adwikara/Ecobin/hardware/motors/lid_motor/connections.jpg

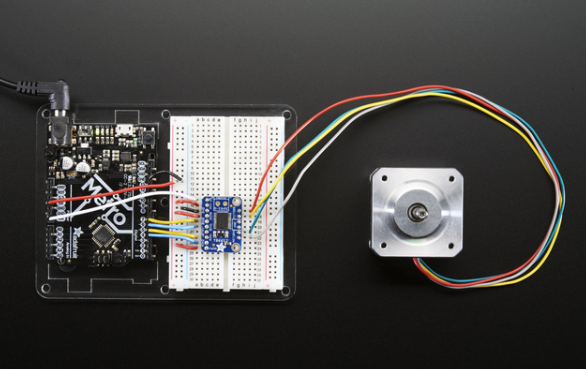
hardware/motors/lid_motor/connections.jpg
