adwikara/Ecobin/software/recognition/figures/best_case_0227/44.png

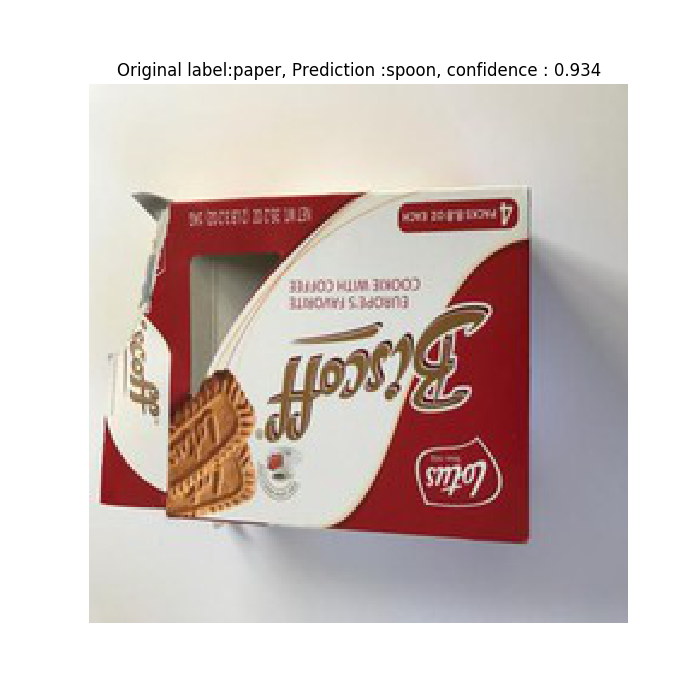
software/recognition/figures/best_case_0227/44.png
