adwikara/Ecobin/hardware/individual_sensors/README.md

This is a directory for all sensor modules used in Ecobin. Each file corresponds to the type of eponymous sensor
