adwikara/Ecobin/hardware/pi/README.md

# Pi Control
The ecobin.py script integrates the RasPi, sensors, and the backend. It is used for prototyping purposes.
