adwikara/Ecobin/hardware/motors/lid_motor/README.md

## Setup
1. Connect the Arduino, motor, and driver as shown in connections.jpg
2. Compile and load the code into the Arduino Uno
2. Power the Arduino via the Pi
