adwikara/Ecobin/Architechture.png

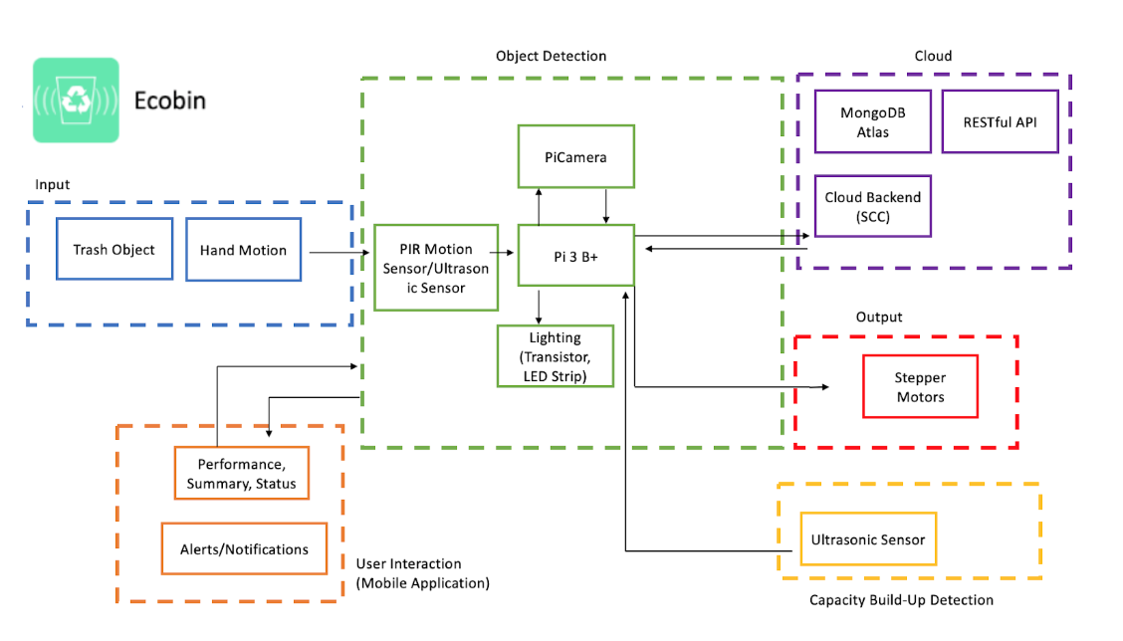
Architechture.png
