adwikara/Ecobin/hardware/pi/block_diagram.jpg

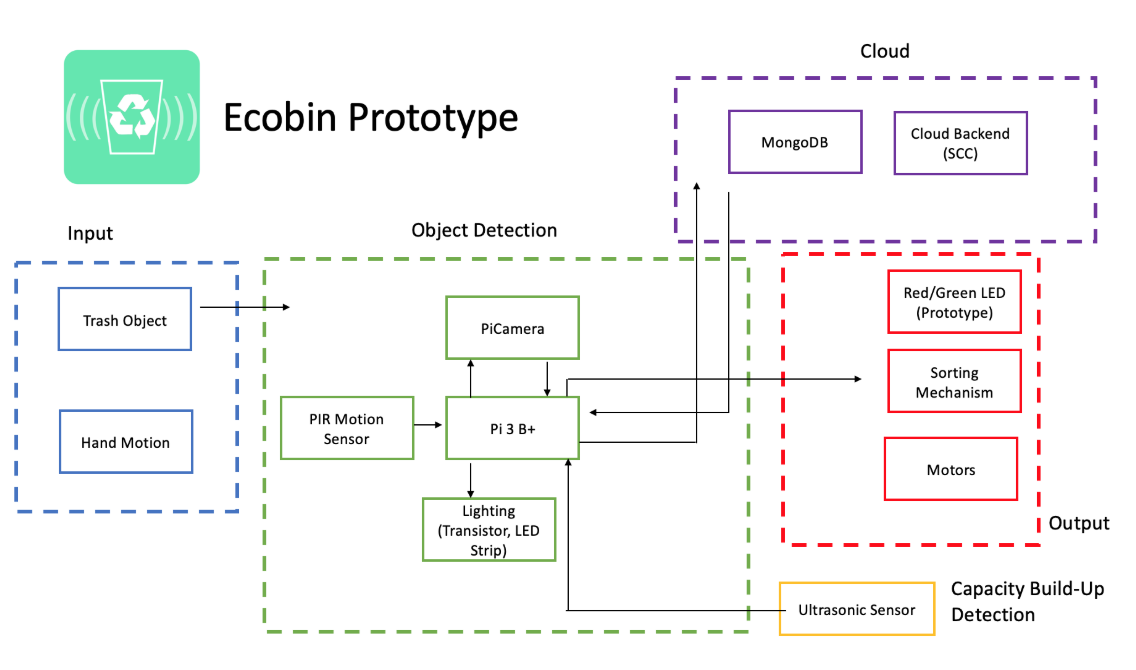
hardware/pi/block_diagram.jpg
