adwikara/Ecobin/hardware/pi/hw_connections.jpg

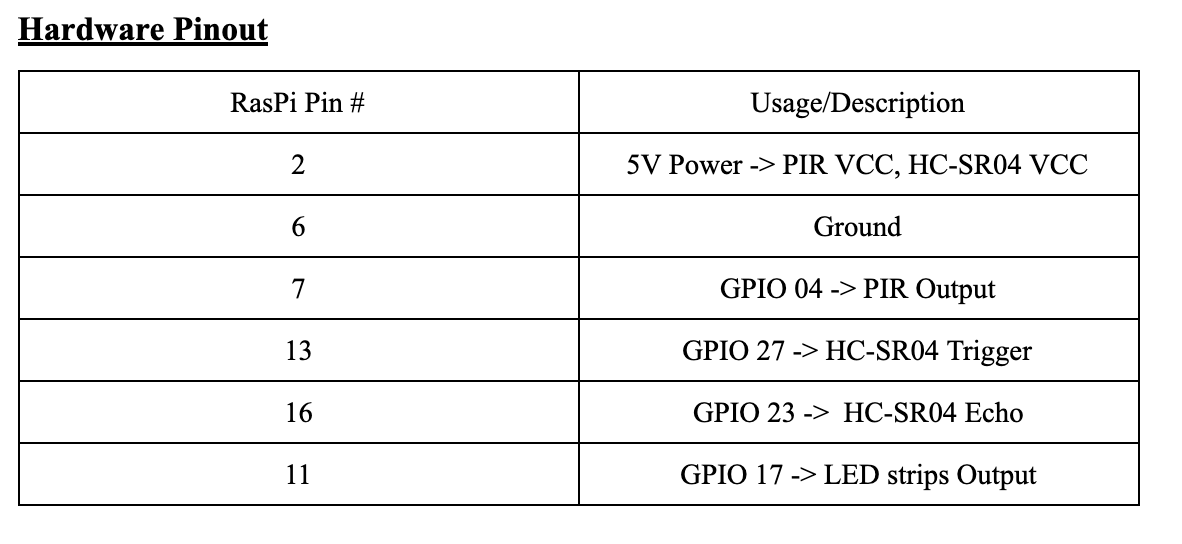
hardware/pi/hw_connections.jpg
