adwikara/Ecobin/hardware/Schematic.png

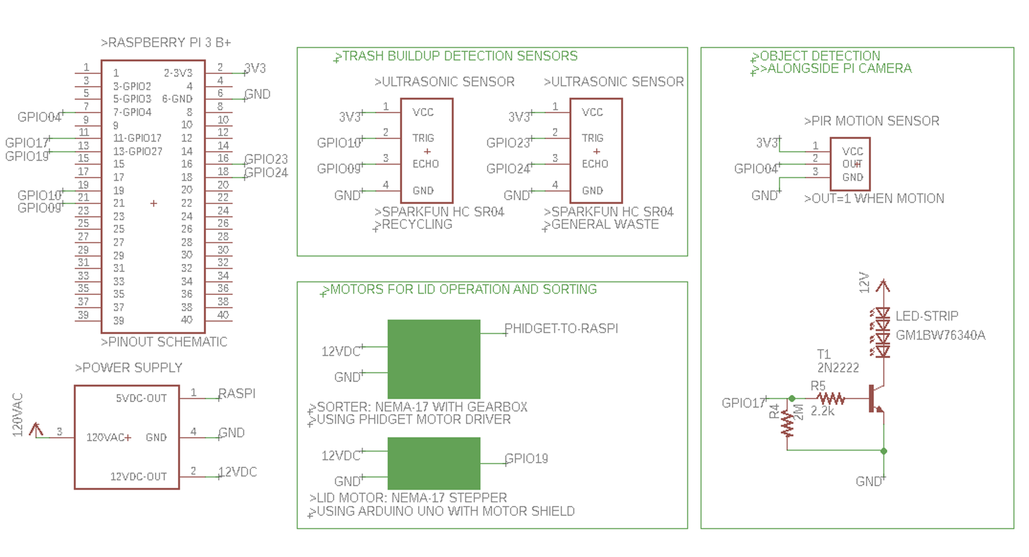
hardware/Schematic.png
