adwikara/Ecobin/software/recognition/figures/best_case_0227/0.png

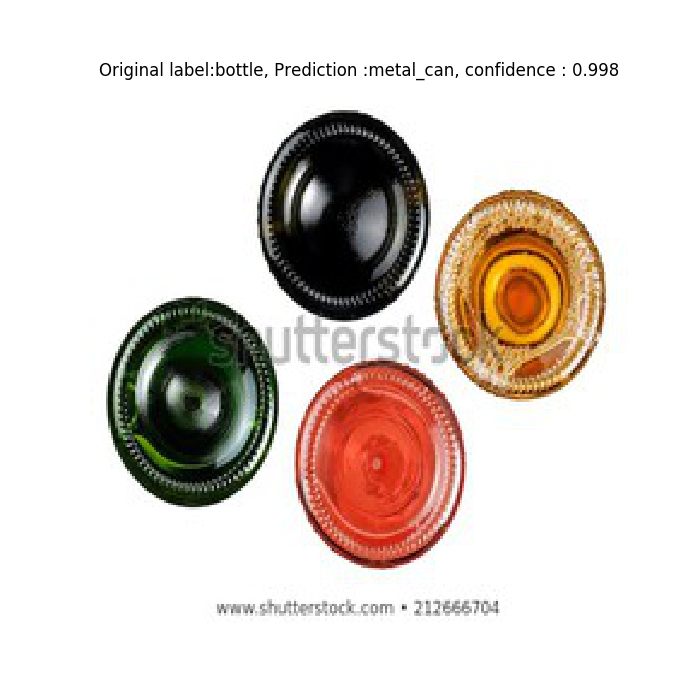
software/recognition/figures/best_case_0227/0.png
