adwikara/Ecobin/software/recognition/figures/best_case_0227/1.png

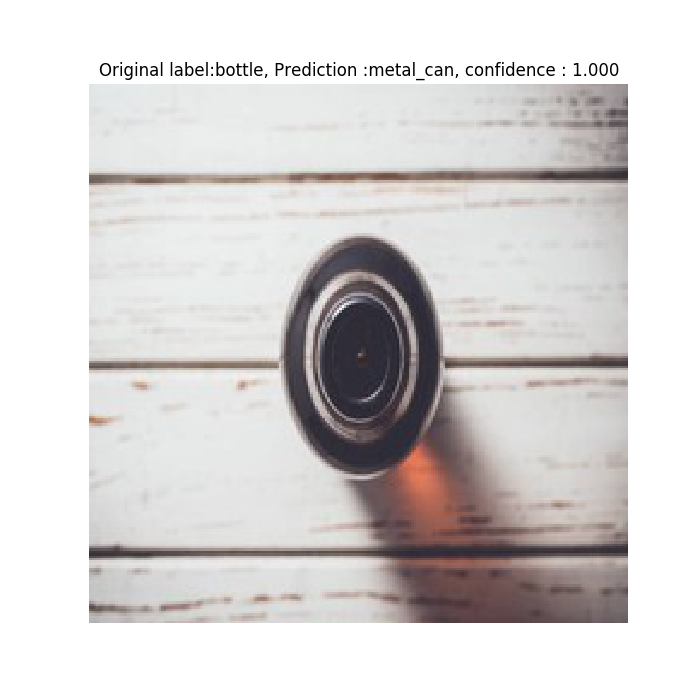
software/recognition/figures/best_case_0227/1.png
