adwikara/Ecobin/software/recognition/figures/best_case_0227/2.png

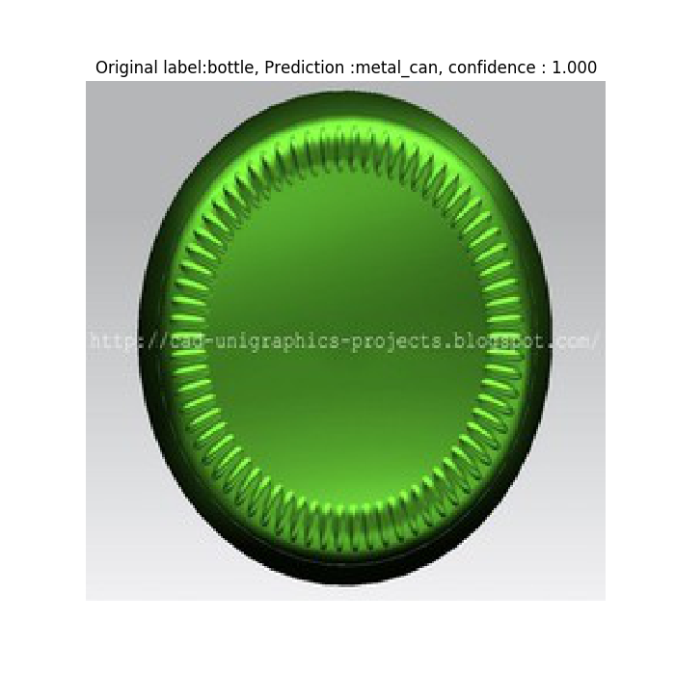
software/recognition/figures/best_case_0227/2.png
