adwikara/Ecobin/software/recognition/figures/best_case_0227/3.png

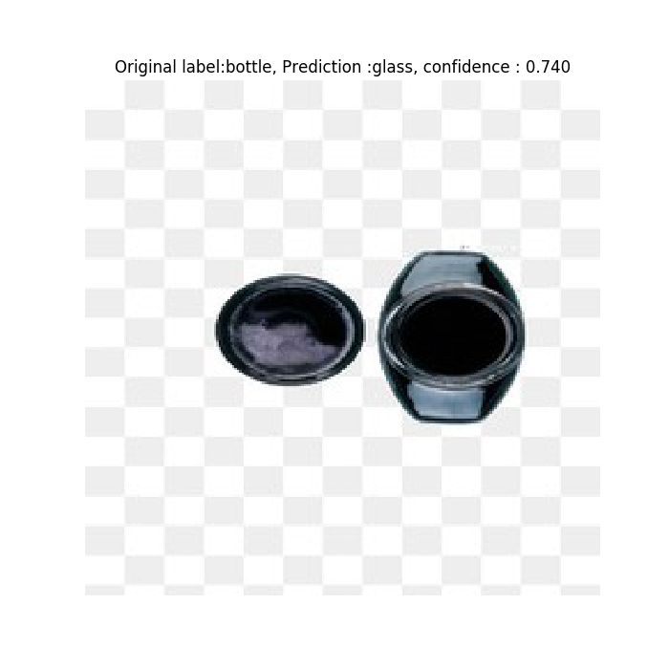
software/recognition/figures/best_case_0227/3.png
