adwikara/Ecobin/software/recognition/figures/best_case_0227/4.png

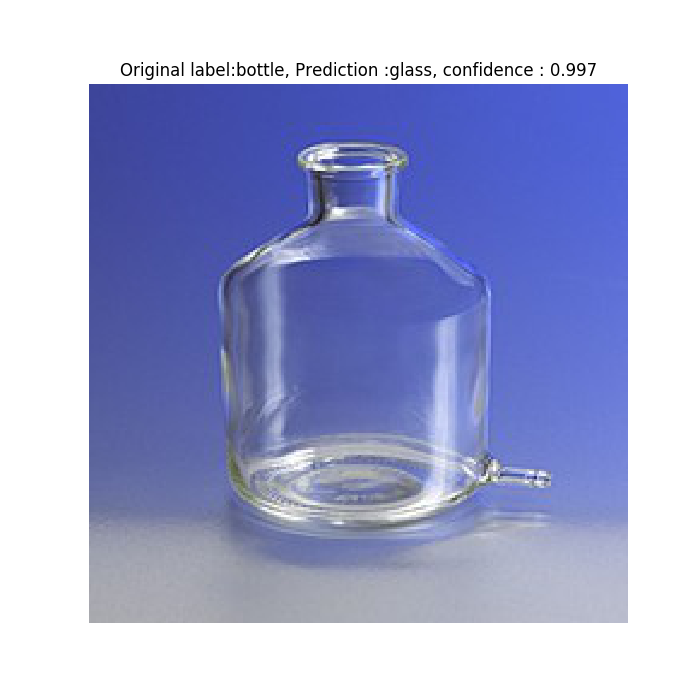
software/recognition/figures/best_case_0227/4.png
