adwikara/Ecobin/software/recognition/figures/best_case_0227/5.png

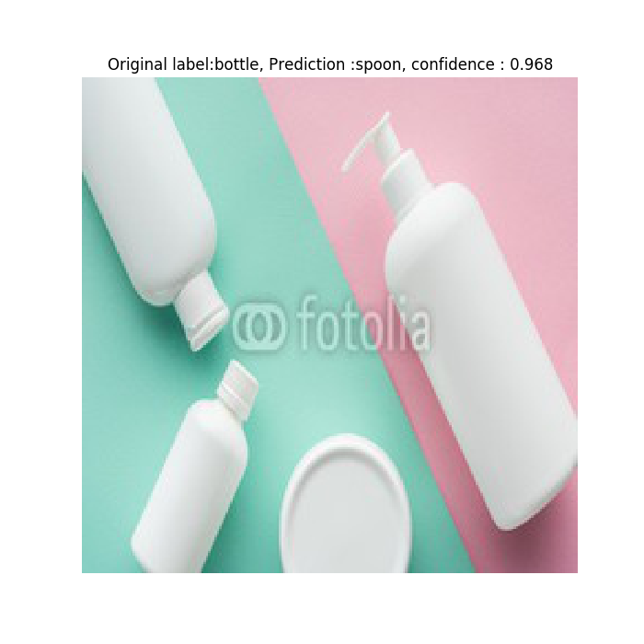
software/recognition/figures/best_case_0227/5.png
