adwikara/Ecobin/software/recognition/figures/best_case_0227/6.png

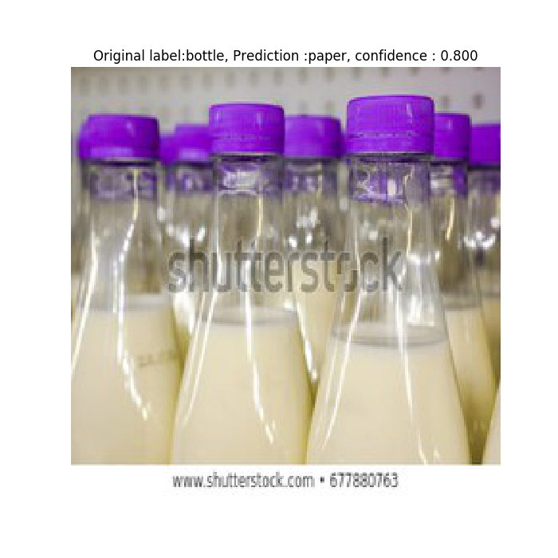
software/recognition/figures/best_case_0227/6.png
