adwikara/Ecobin/software/recognition/figures/best_case_0227/7.png

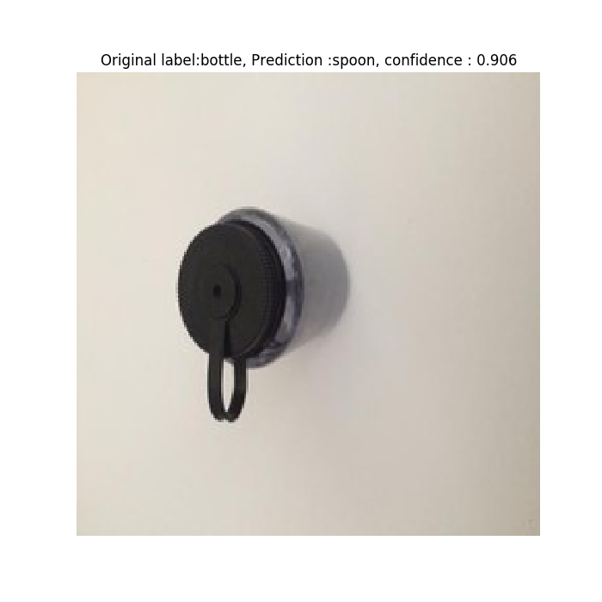
software/recognition/figures/best_case_0227/7.png
