adwikara/Ecobin/software/recognition/figures/best_case_0227/8.png

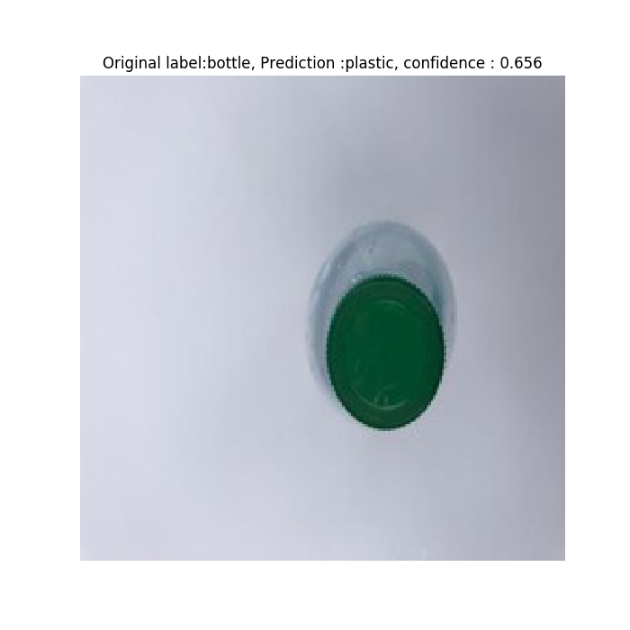
software/recognition/figures/best_case_0227/8.png
