adwikara/Ecobin/software/recognition/figures/best_case_0227/9.png

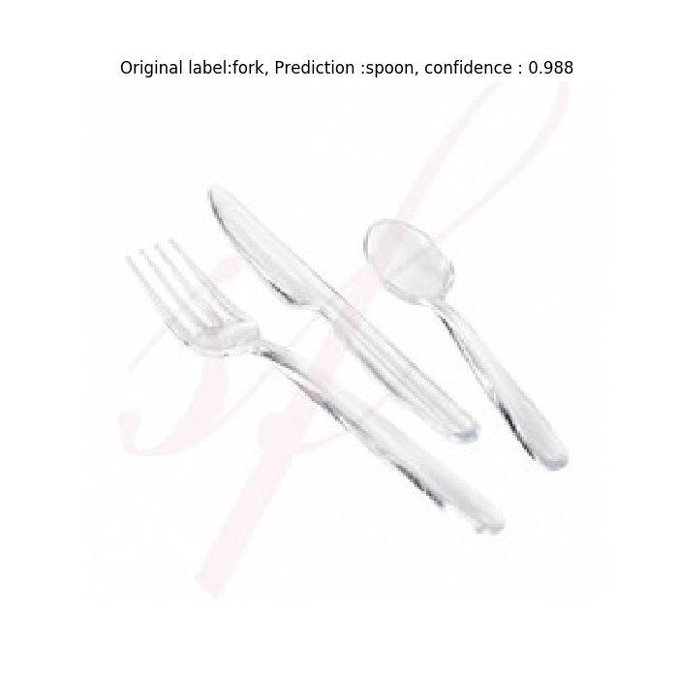
software/recognition/figures/best_case_0227/9.png
