adwikara/Ecobin/software/recognition/figures/best_case_0227/10.png

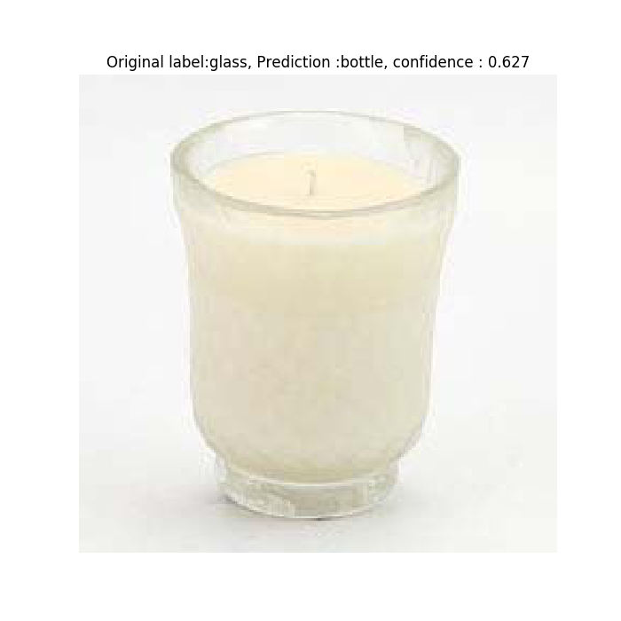
software/recognition/figures/best_case_0227/10.png
