adwikara/Ecobin/software/recognition/figures/best_case_0227/11.png

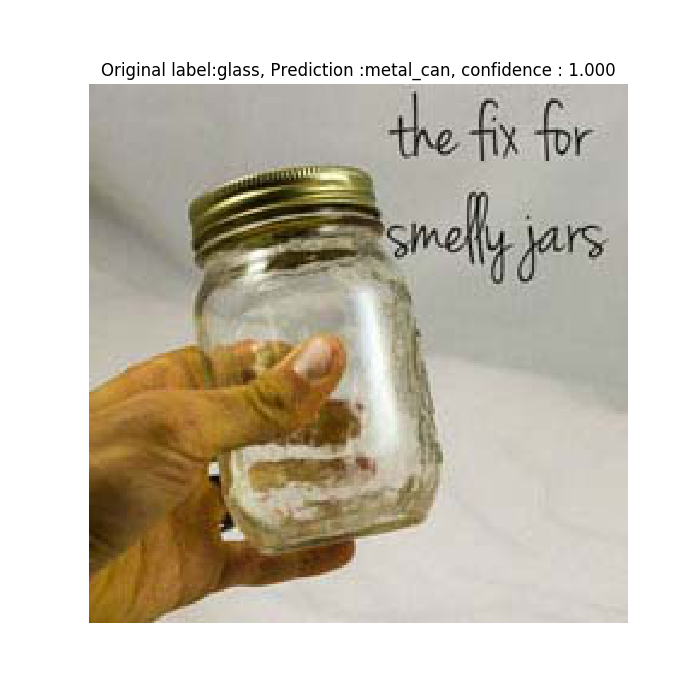
software/recognition/figures/best_case_0227/11.png
