adwikara/Ecobin/software/recognition/figures/best_case_0227/12.png

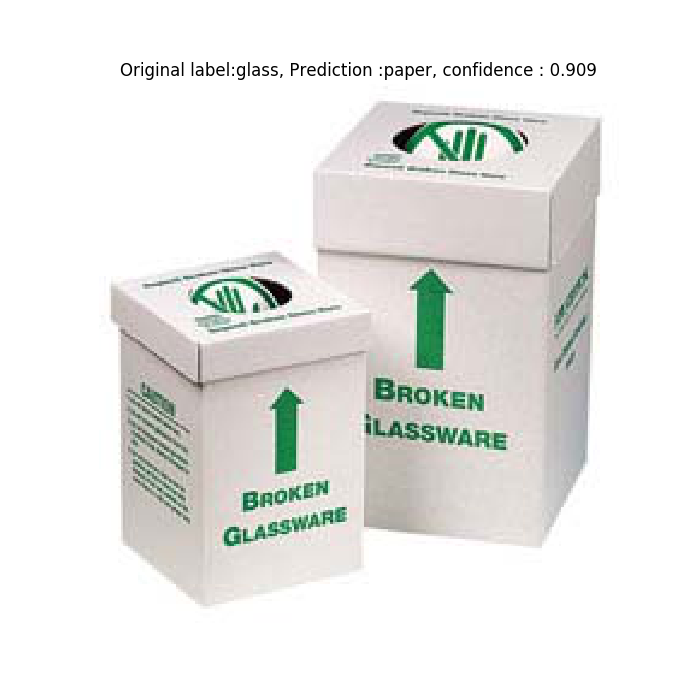
software/recognition/figures/best_case_0227/12.png
