adwikara/Ecobin/software/recognition/figures/best_case_0227/13.png

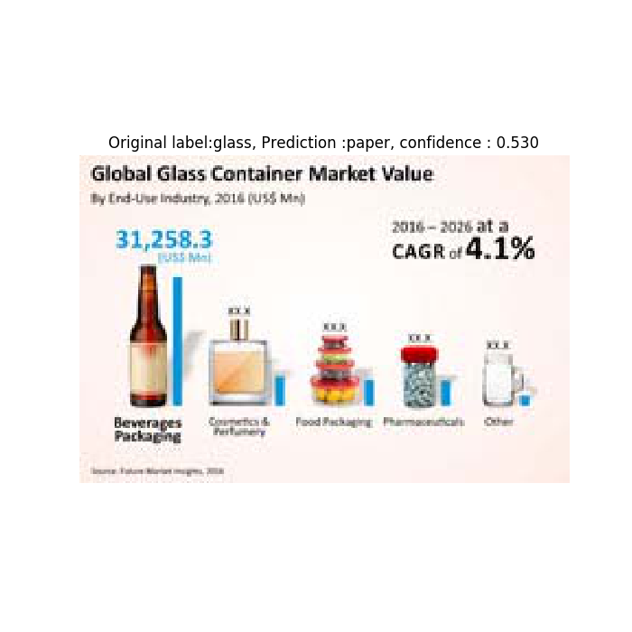
software/recognition/figures/best_case_0227/13.png
