adwikara/Ecobin/software/recognition/figures/best_case_0227/14.png

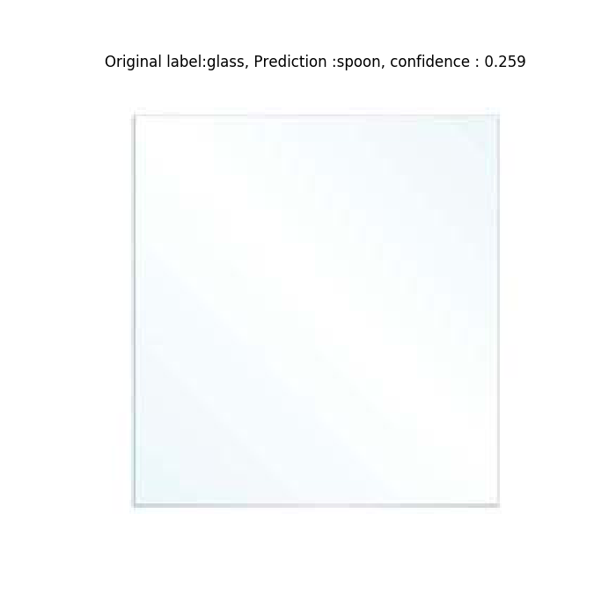
software/recognition/figures/best_case_0227/14.png
