adwikara/Ecobin/software/recognition/figures/best_case_0227/15.png

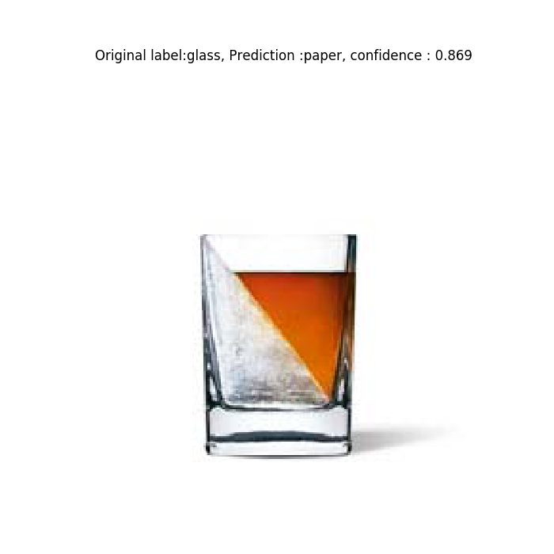
software/recognition/figures/best_case_0227/15.png
