adwikara/Ecobin/software/recognition/figures/best_case_0227/16.png

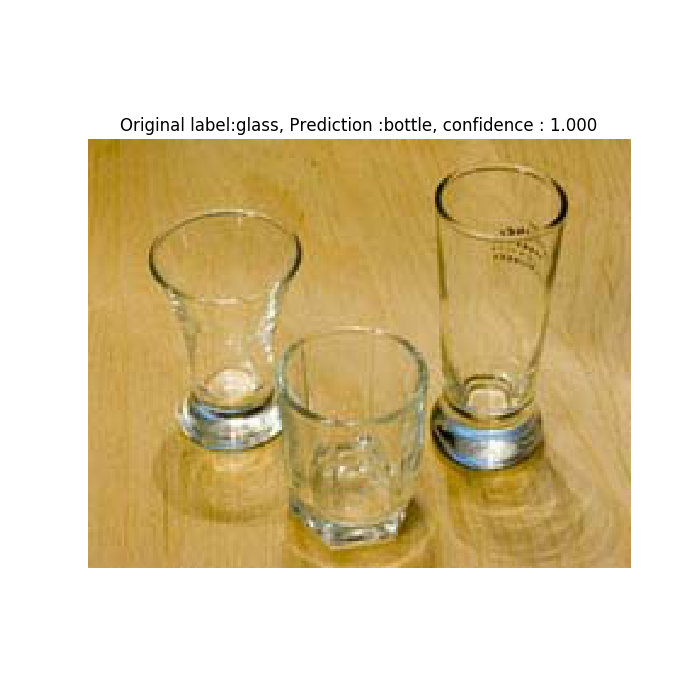
software/recognition/figures/best_case_0227/16.png
