adwikara/Ecobin/software/recognition/figures/best_case_0227/17.png

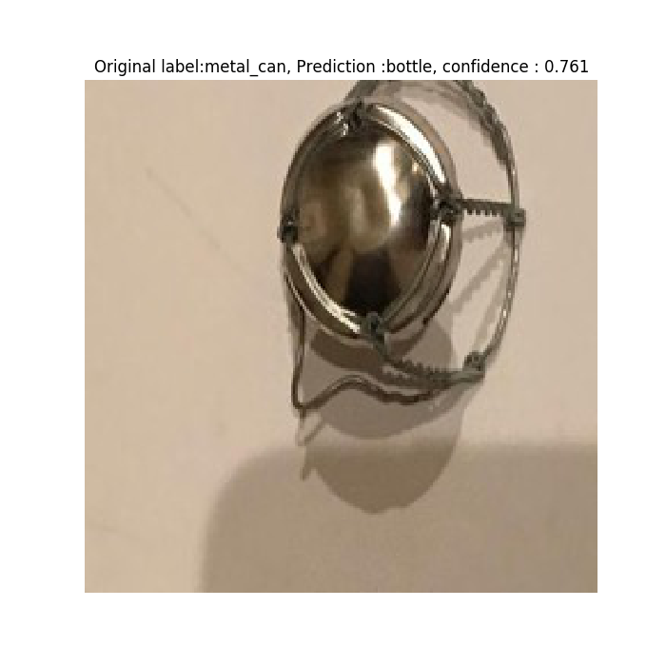
software/recognition/figures/best_case_0227/17.png
