adwikara/Ecobin/software/recognition/figures/best_case_0227/18.png

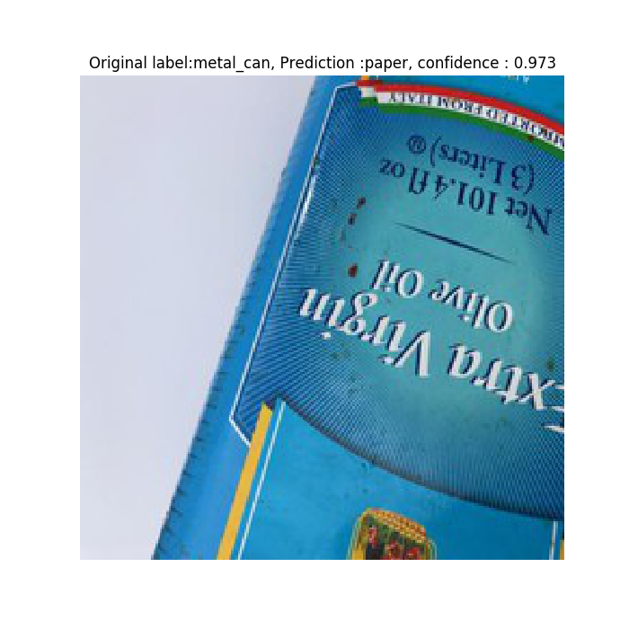
software/recognition/figures/best_case_0227/18.png
