adwikara/Ecobin/software/recognition/figures/best_case_0227/19.png

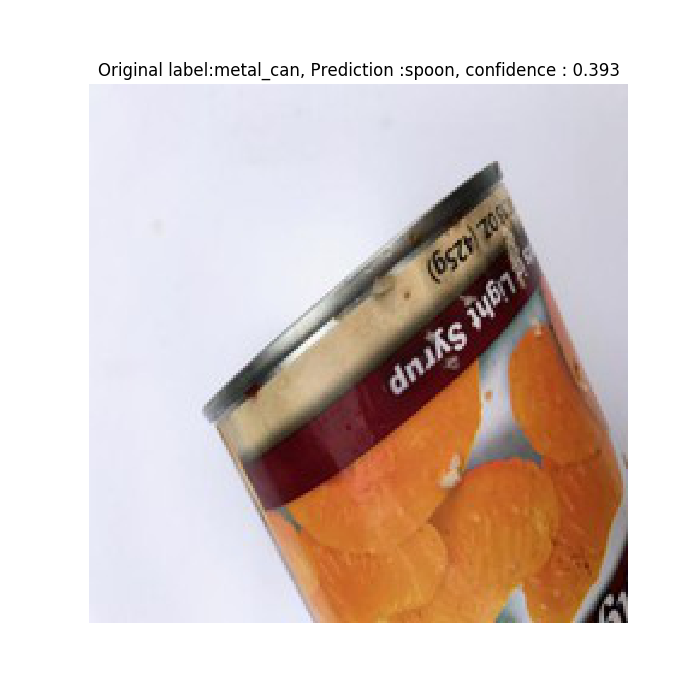
software/recognition/figures/best_case_0227/19.png
