adwikara/Ecobin/software/recognition/figures/best_case_0227/20.png

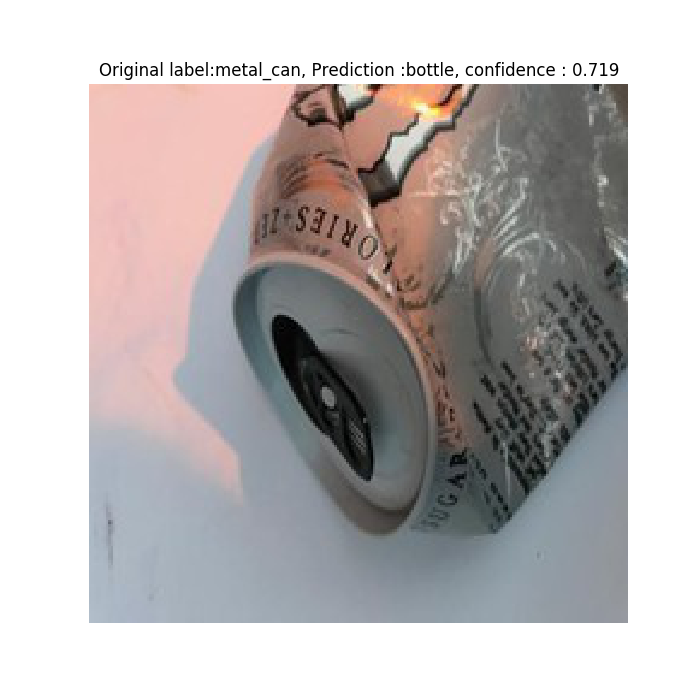
software/recognition/figures/best_case_0227/20.png
