adwikara/Ecobin/software/recognition/figures/best_case_0227/21.png

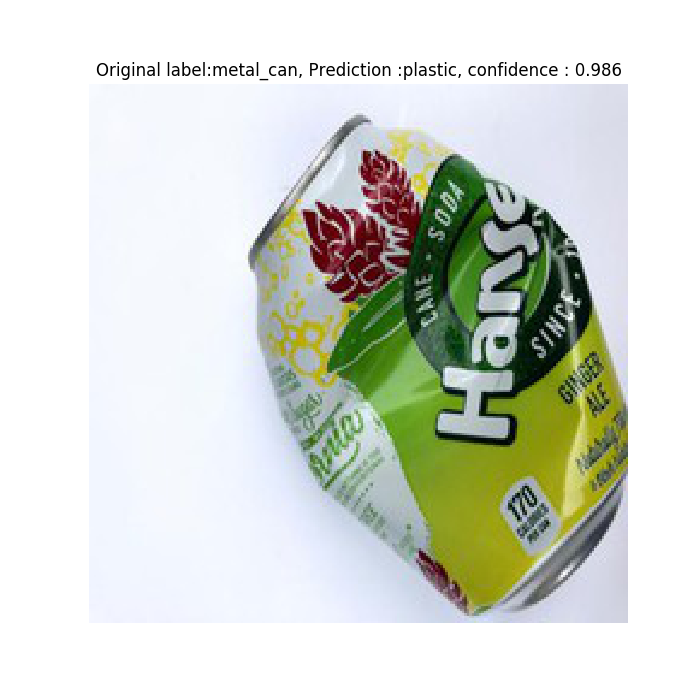
software/recognition/figures/best_case_0227/21.png
