adwikara/Ecobin/software/recognition/figures/best_case_0227/22.png

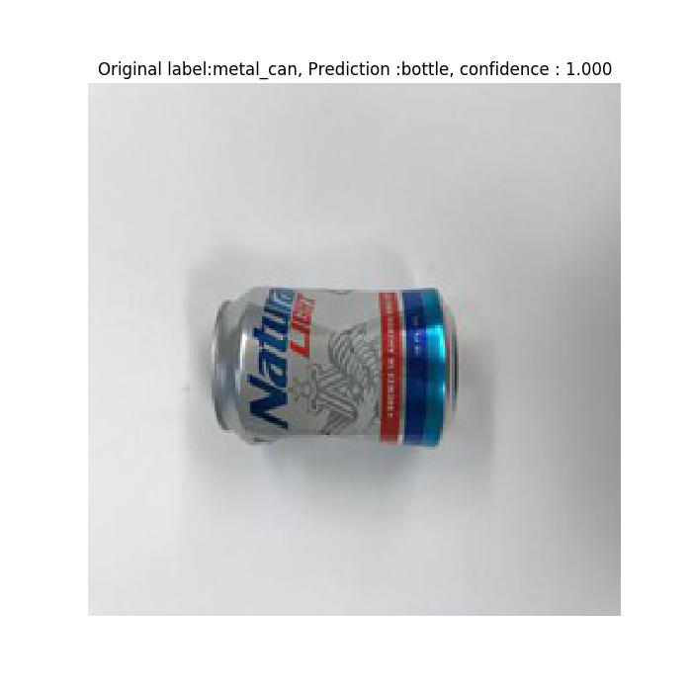
software/recognition/figures/best_case_0227/22.png
