adwikara/Ecobin/software/recognition/figures/best_case_0227/23.png

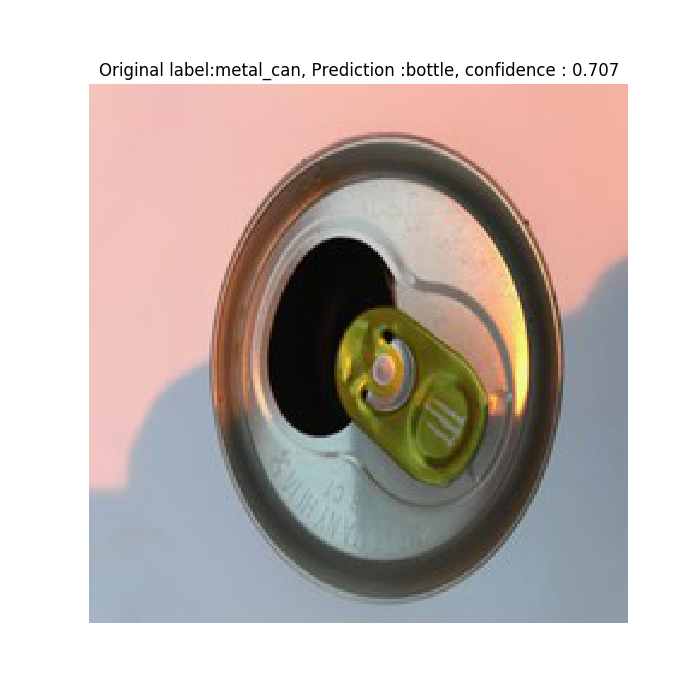
software/recognition/figures/best_case_0227/23.png
