adwikara/Ecobin/software/recognition/figures/best_case_0227/24.png

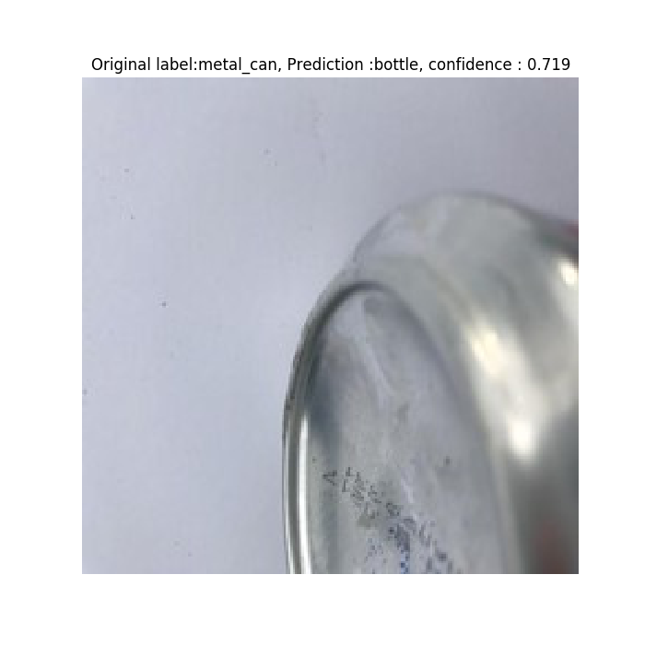
software/recognition/figures/best_case_0227/24.png
