adwikara/Ecobin/software/recognition/figures/best_case_0227/25.png

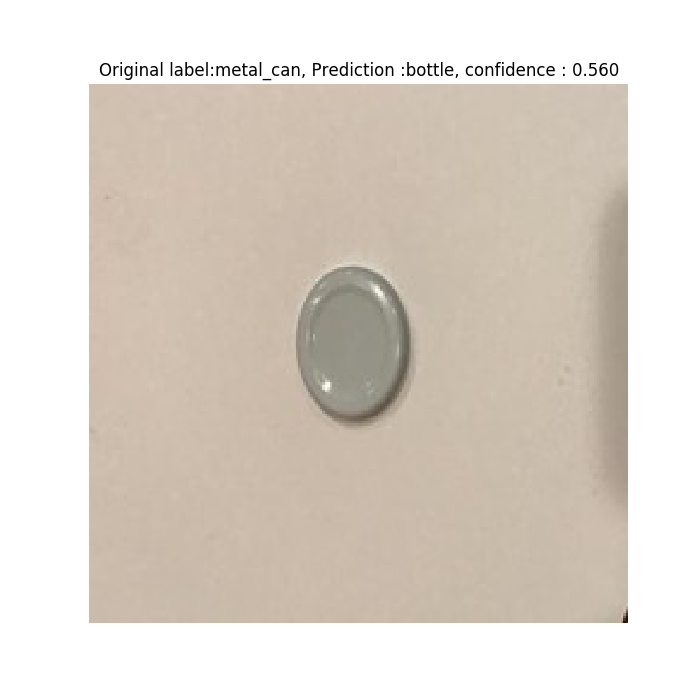
software/recognition/figures/best_case_0227/25.png
