adwikara/Ecobin/software/recognition/figures/best_case_0227/26.png

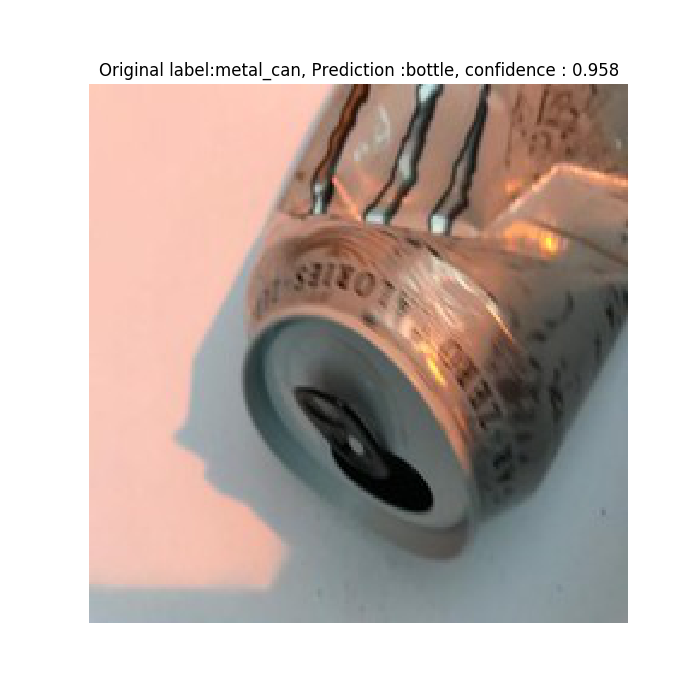
software/recognition/figures/best_case_0227/26.png
