adwikara/Ecobin/software/recognition/figures/best_case_0227/27.png

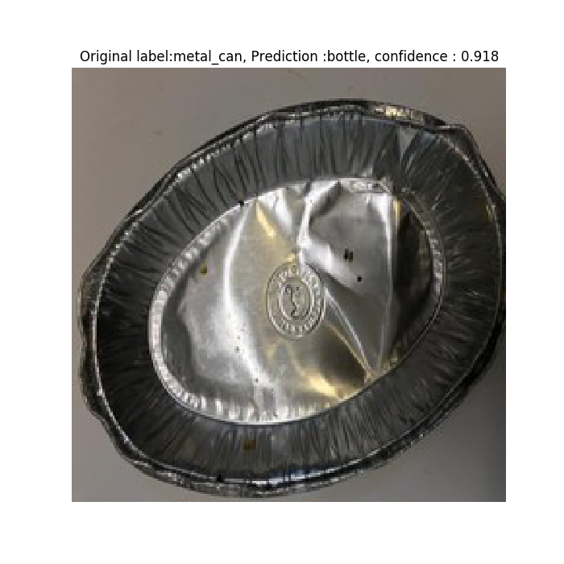
software/recognition/figures/best_case_0227/27.png
