adwikara/Ecobin/software/recognition/figures/best_case_0227/28.png

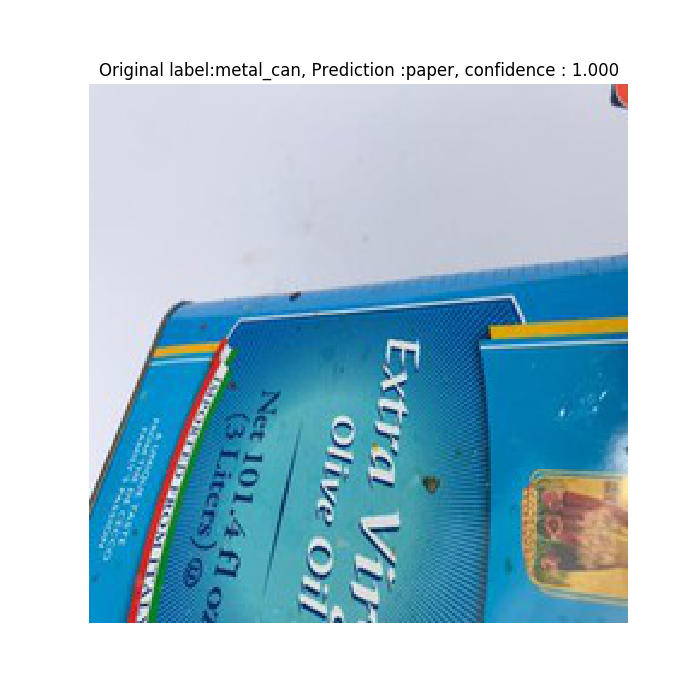
software/recognition/figures/best_case_0227/28.png
