adwikara/Ecobin/software/recognition/figures/best_case_0227/29.png

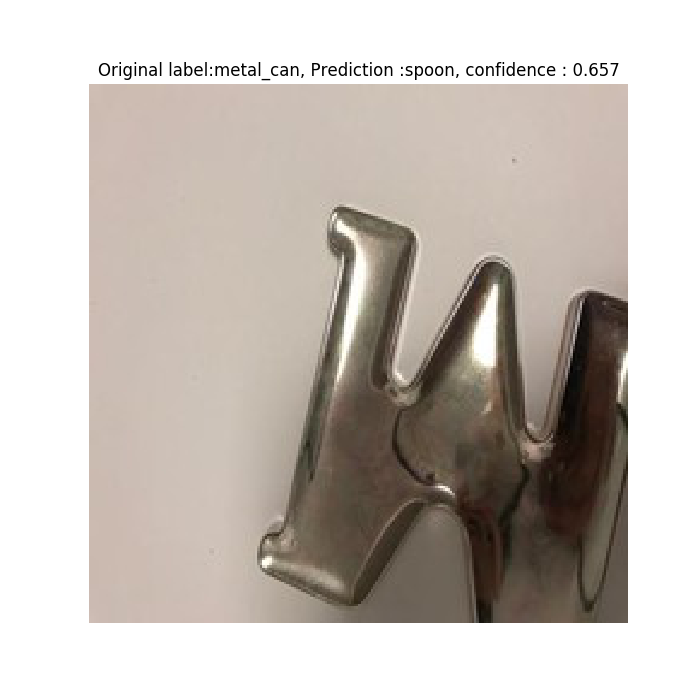
software/recognition/figures/best_case_0227/29.png
