adwikara/Ecobin/software/recognition/figures/best_case_0227/31.png

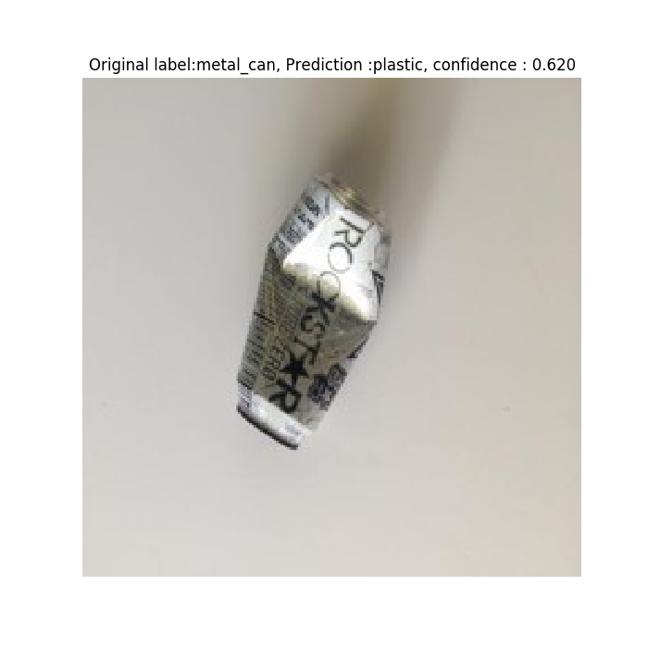
software/recognition/figures/best_case_0227/31.png
