adwikara/Ecobin/software/recognition/figures/best_case_0227/32.png

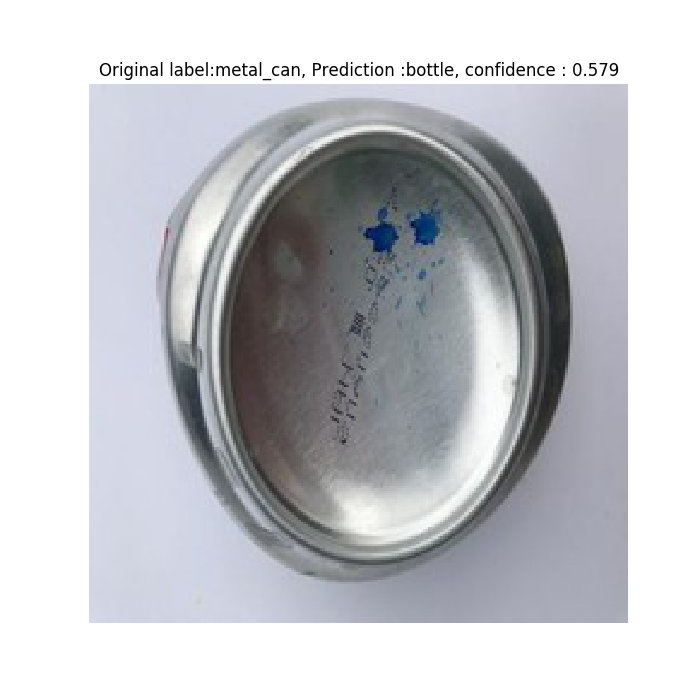
software/recognition/figures/best_case_0227/32.png
