adwikara/Ecobin/software/recognition/figures/best_case_0227/33.png

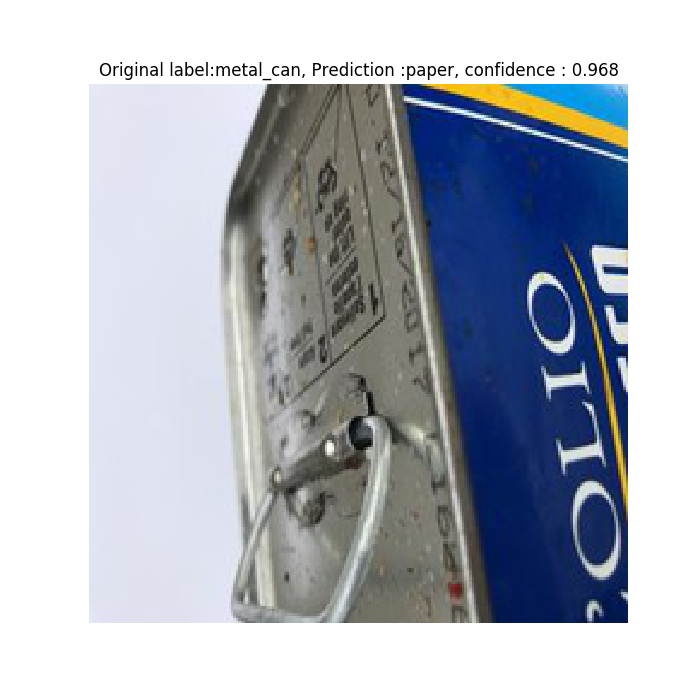
software/recognition/figures/best_case_0227/33.png
