adwikara/Ecobin/software/recognition/figures/best_case_0227/34.png

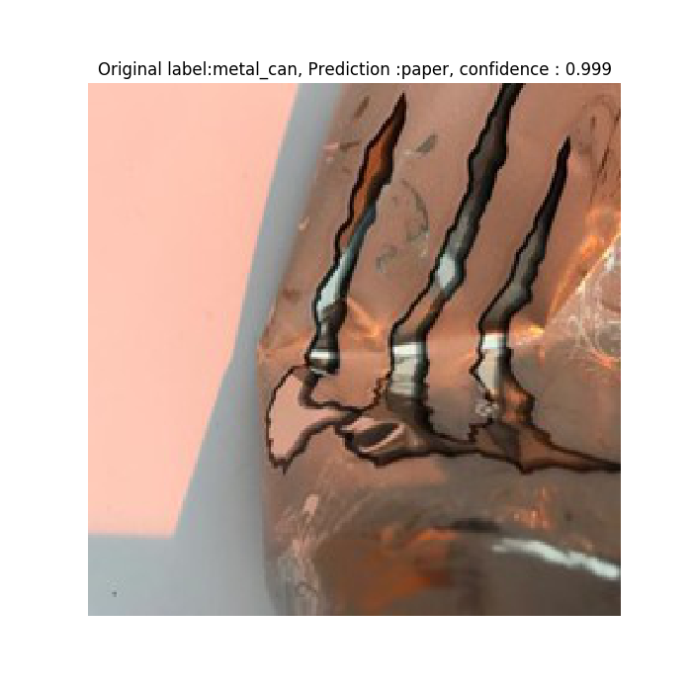
software/recognition/figures/best_case_0227/34.png
