adwikara/Ecobin/software/recognition/figures/best_case_0227/35.png

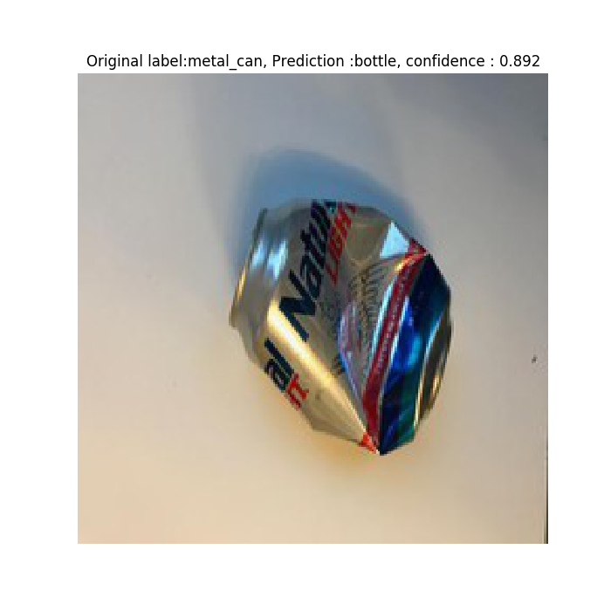
software/recognition/figures/best_case_0227/35.png
