adwikara/Ecobin/software/recognition/figures/best_case_0227/36.png

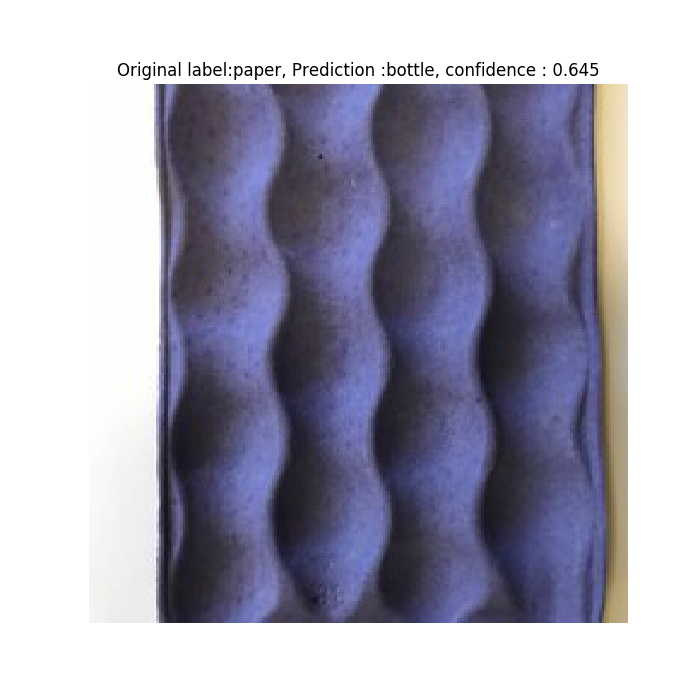
software/recognition/figures/best_case_0227/36.png
