adwikara/Ecobin/software/recognition/figures/best_case_0227/37.png

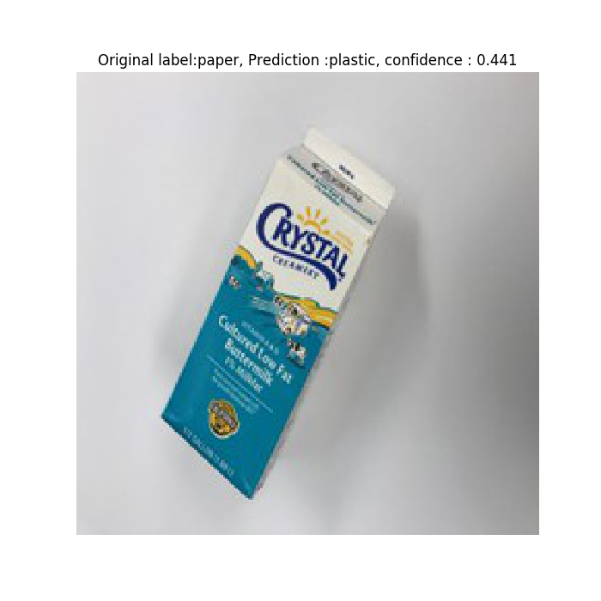
software/recognition/figures/best_case_0227/37.png
