adwikara/Ecobin/software/recognition/figures/best_case_0227/38.png

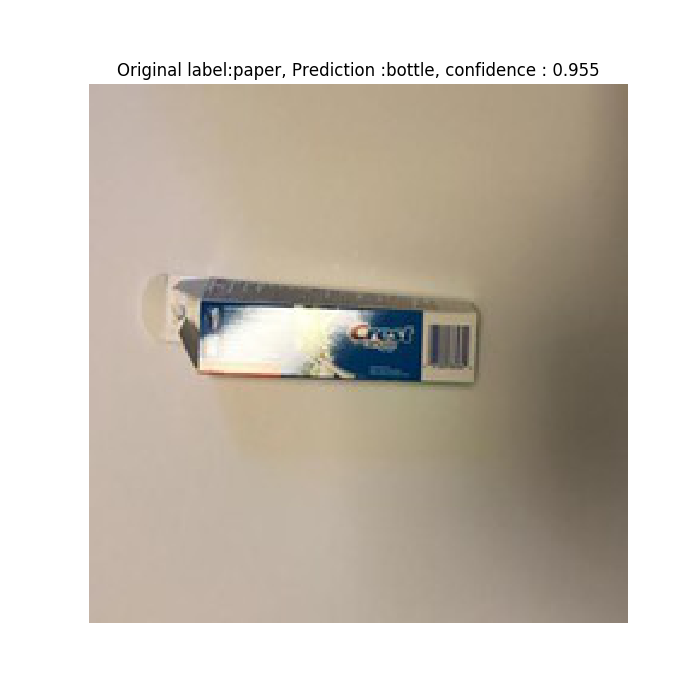
software/recognition/figures/best_case_0227/38.png
