adwikara/Ecobin/software/recognition/figures/best_case_0227/39.png

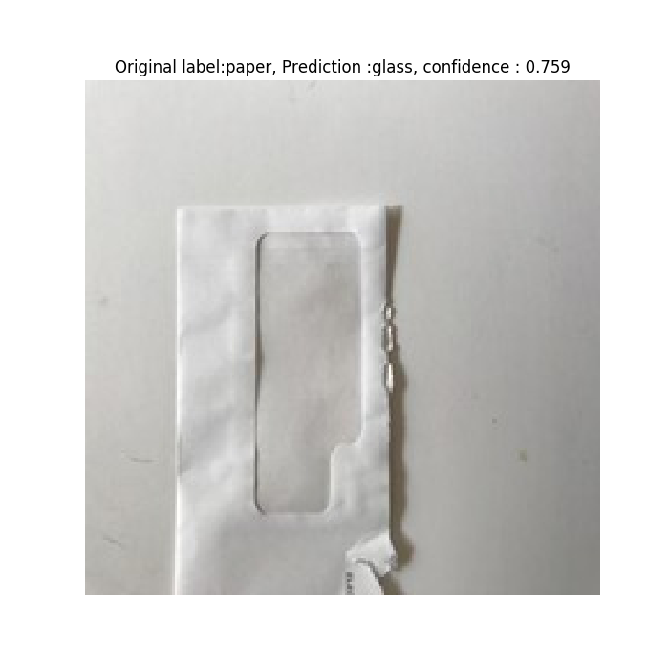
software/recognition/figures/best_case_0227/39.png
