adwikara/Ecobin/software/recognition/figures/best_case_0227/40.png

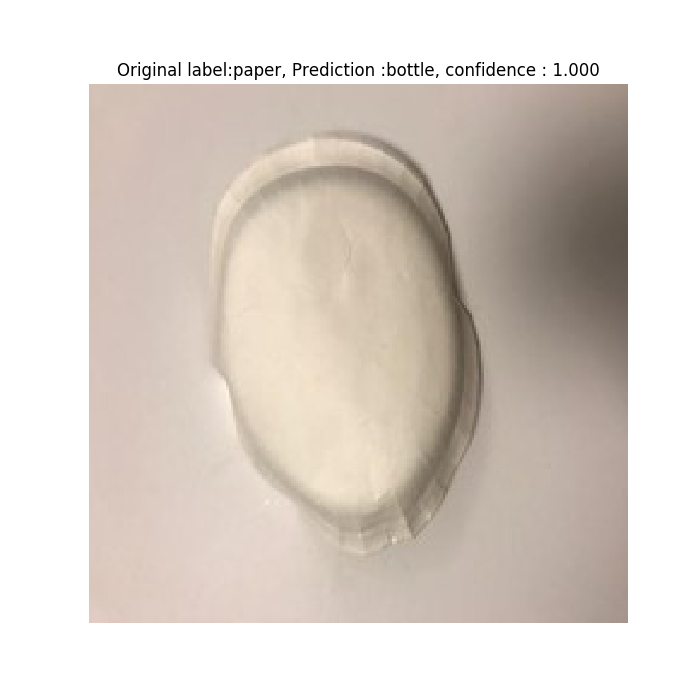
software/recognition/figures/best_case_0227/40.png
