adwikara/Ecobin/software/recognition/figures/best_case_0227/41.png

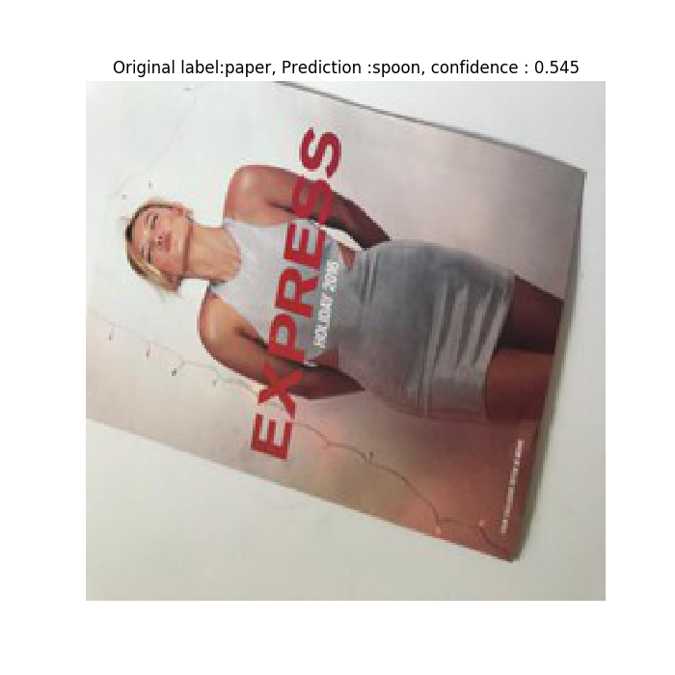
software/recognition/figures/best_case_0227/41.png
