adwikara/Ecobin/software/recognition/figures/best_case_0227/43.png

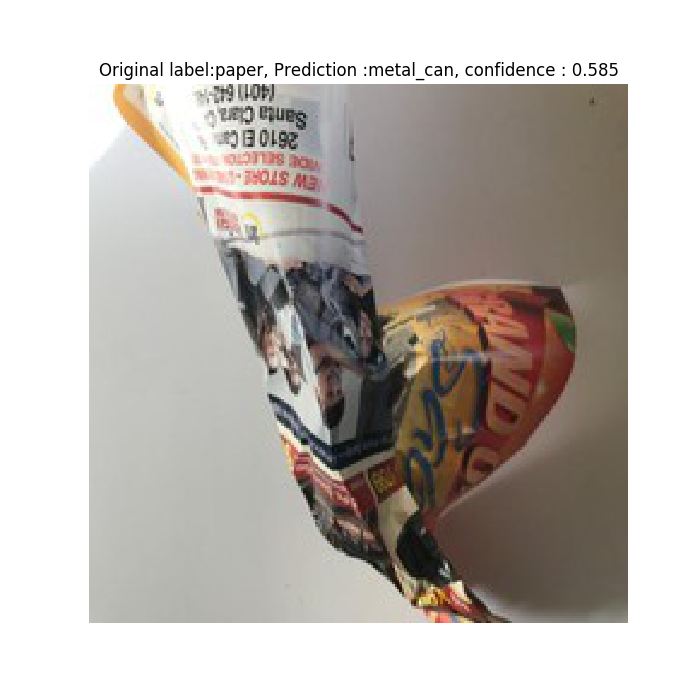
software/recognition/figures/best_case_0227/43.png
