adwikara/Ecobin/software/recognition/figures/best_case_0227/45.png

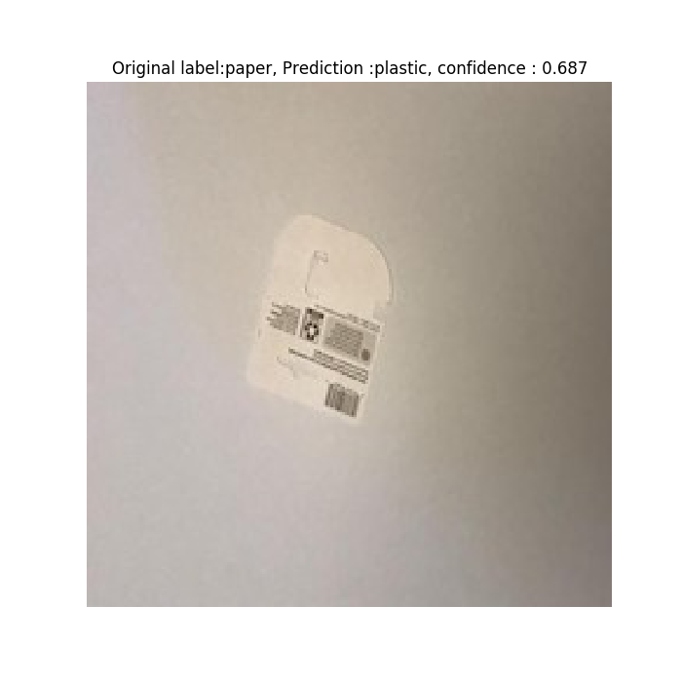
software/recognition/figures/best_case_0227/45.png
