adwikara/Ecobin/software/recognition/figures/best_case_0227/46.png

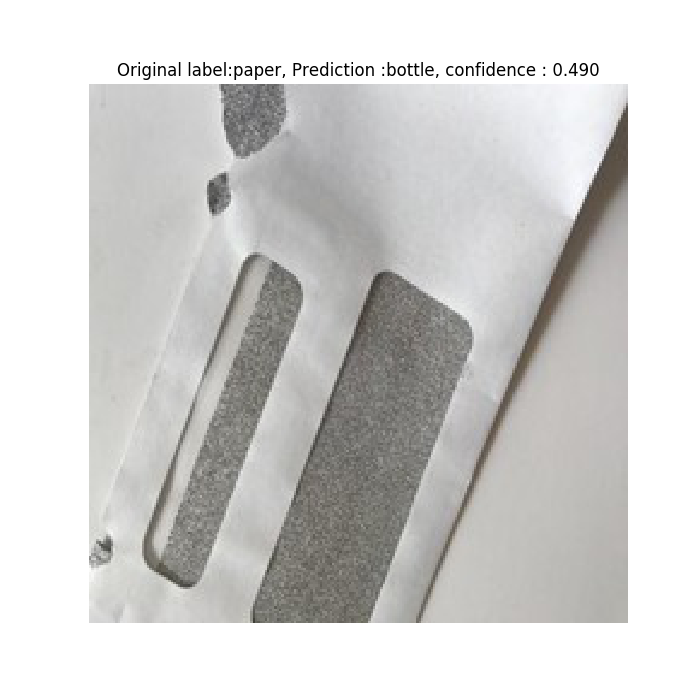
software/recognition/figures/best_case_0227/46.png
