adwikara/Ecobin/software/recognition/figures/best_case_0227/47.png

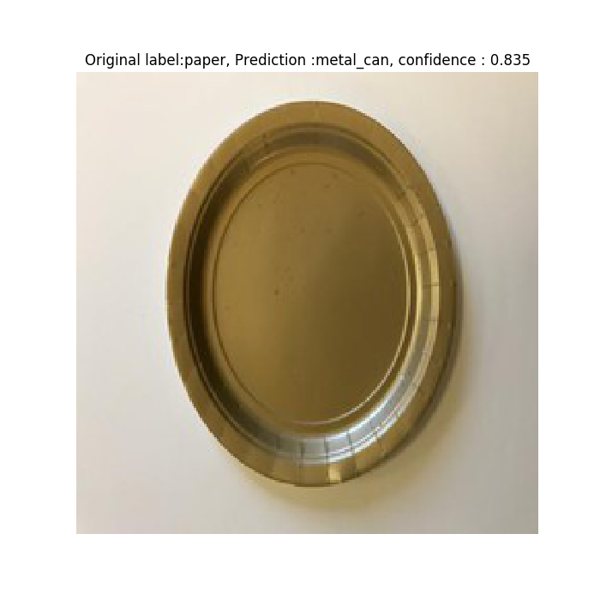
software/recognition/figures/best_case_0227/47.png
