adwikara/Ecobin/software/recognition/figures/best_case_0227/49.png

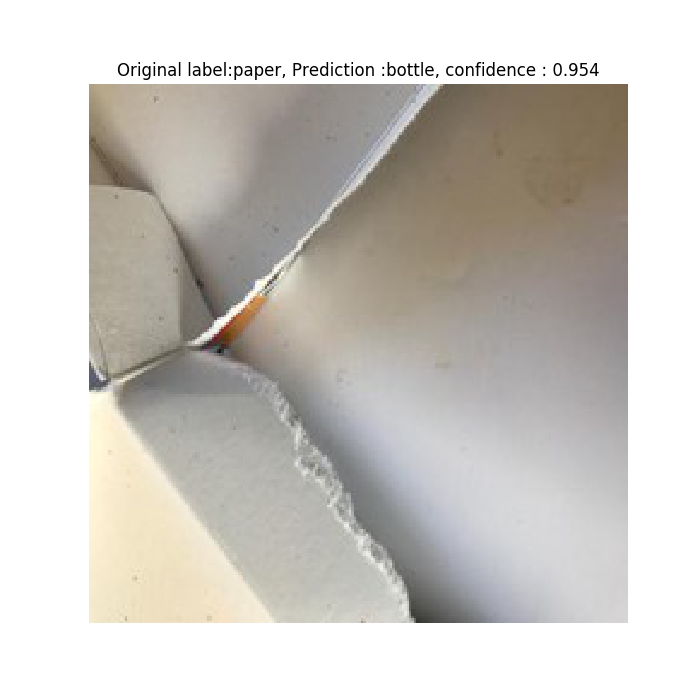
software/recognition/figures/best_case_0227/49.png
