adwikara/Ecobin/software/recognition/figures/best_case_0227/50.png

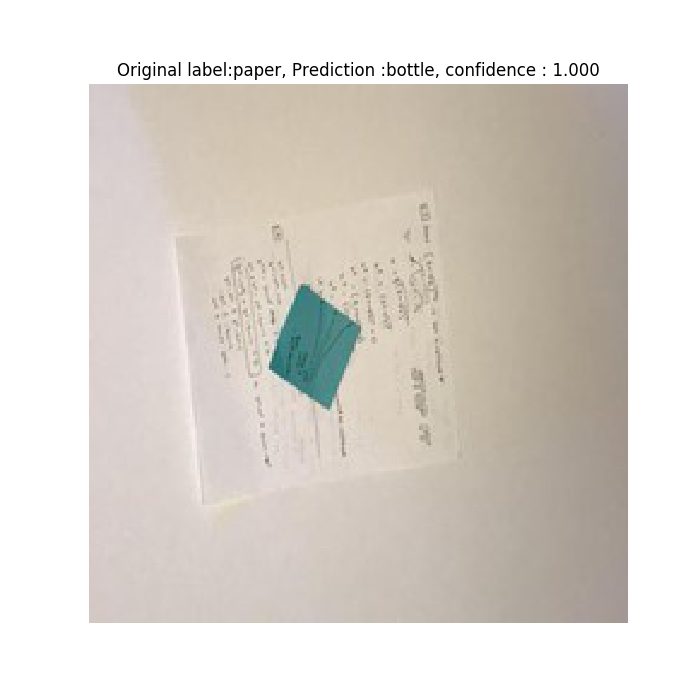
software/recognition/figures/best_case_0227/50.png
