adwikara/Ecobin/software/recognition/figures/best_case_0227/52.png

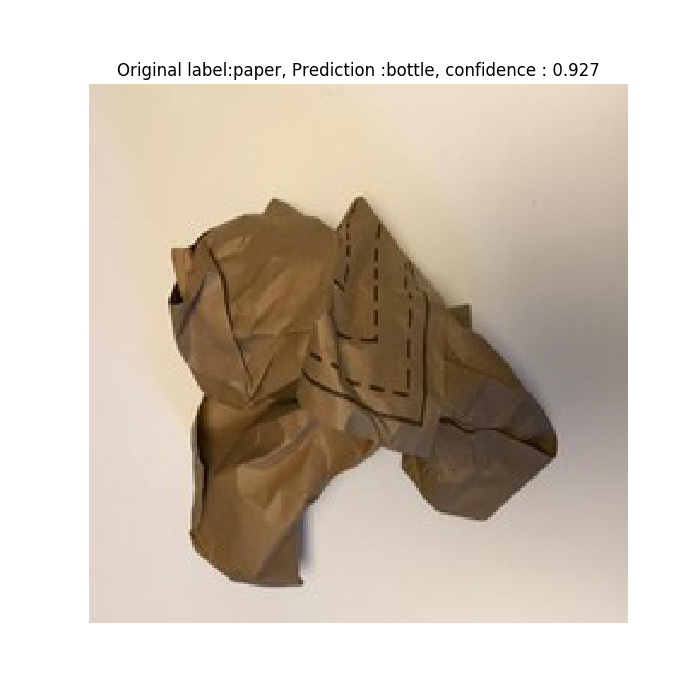
software/recognition/figures/best_case_0227/52.png
