adwikara/Ecobin/software/recognition/figures/best_case_0227/53.png

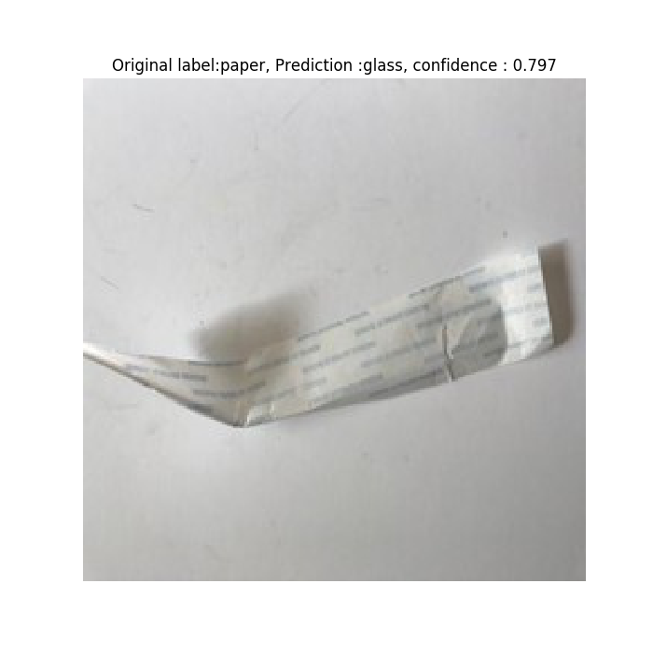
software/recognition/figures/best_case_0227/53.png
