adwikara/Ecobin/software/recognition/figures/best_case_0227/54.png

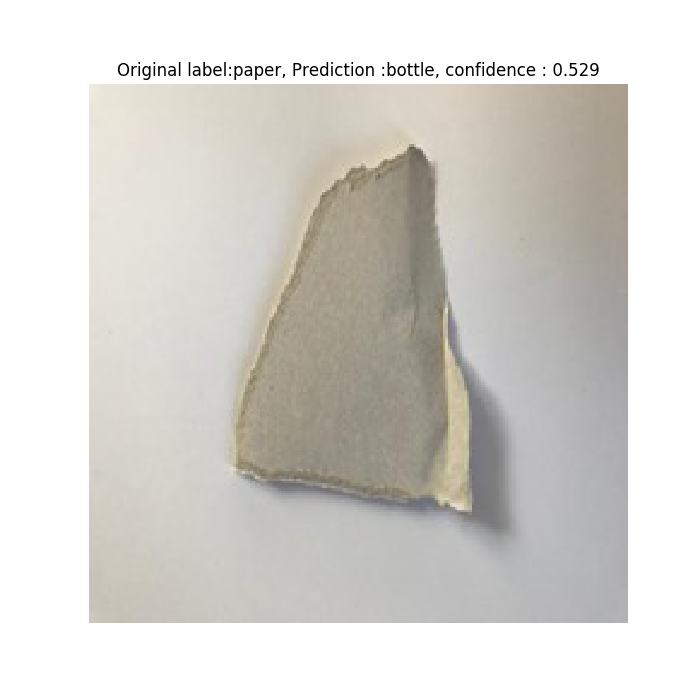
software/recognition/figures/best_case_0227/54.png
