adwikara/Ecobin/software/recognition/figures/best_case_0227/55.png

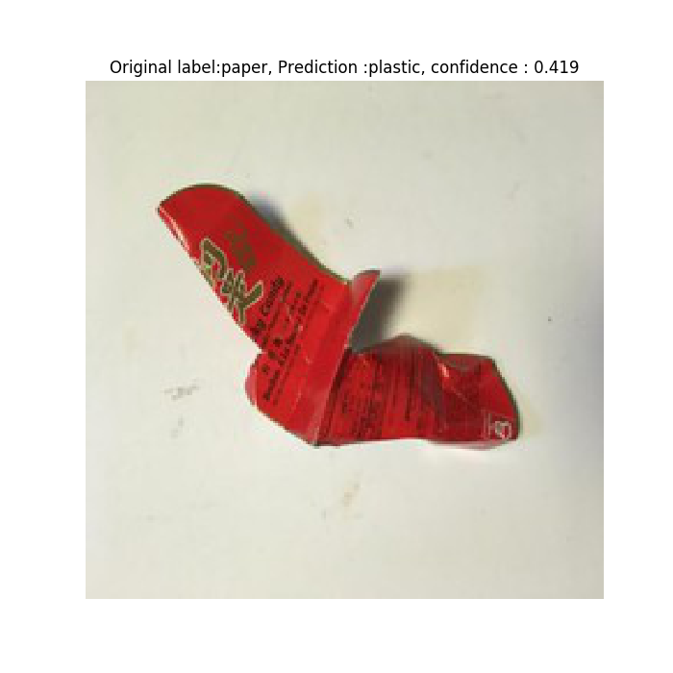
software/recognition/figures/best_case_0227/55.png
