adwikara/Ecobin/software/recognition/figures/best_case_0227/56.png

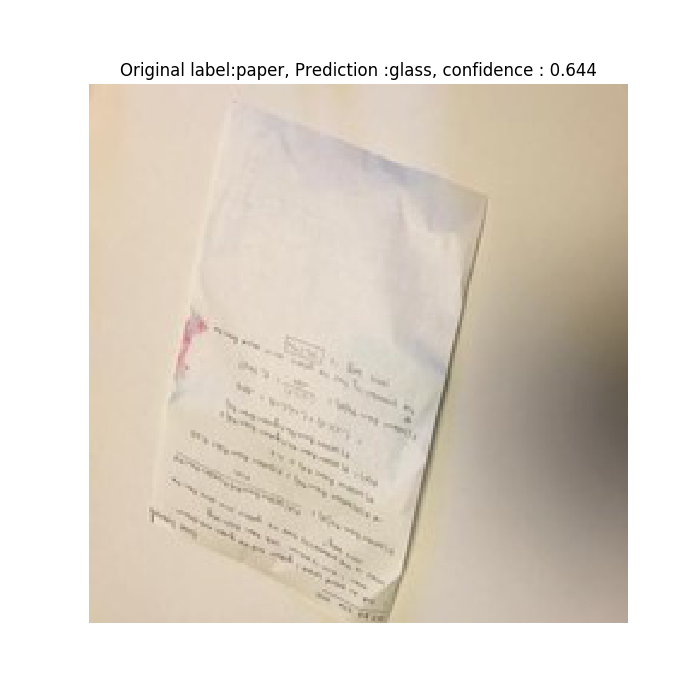
software/recognition/figures/best_case_0227/56.png
