adwikara/Ecobin/software/recognition/figures/best_case_0227/57.png

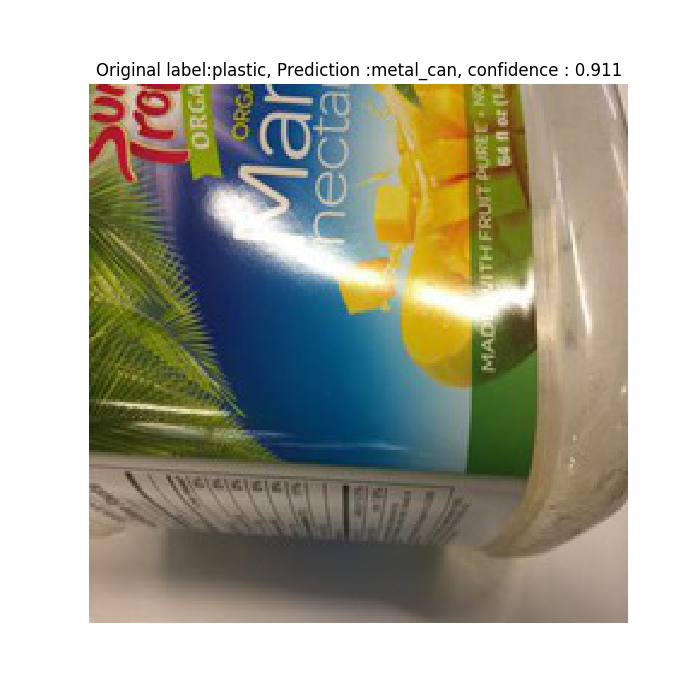
software/recognition/figures/best_case_0227/57.png
