adwikara/Ecobin/software/recognition/figures/best_case_0227/59.png

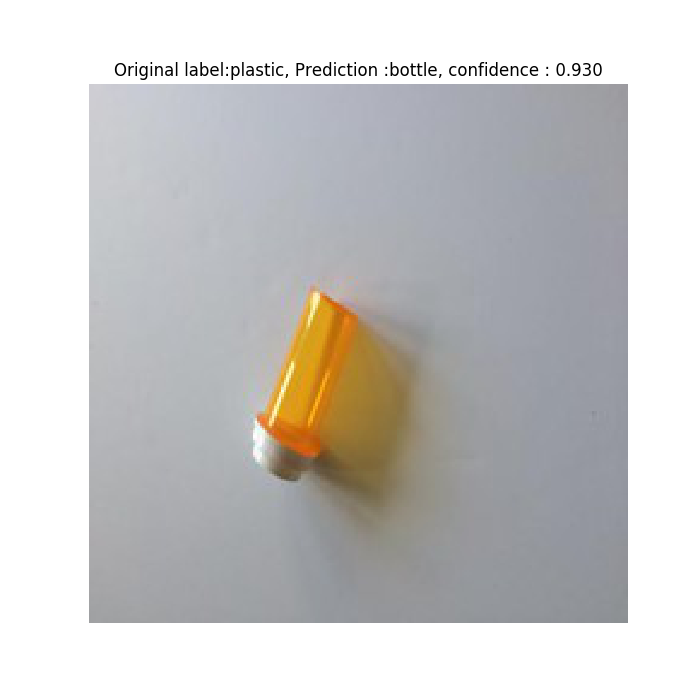
software/recognition/figures/best_case_0227/59.png
