adwikara/Ecobin/software/recognition/figures/best_case_0227/60.png

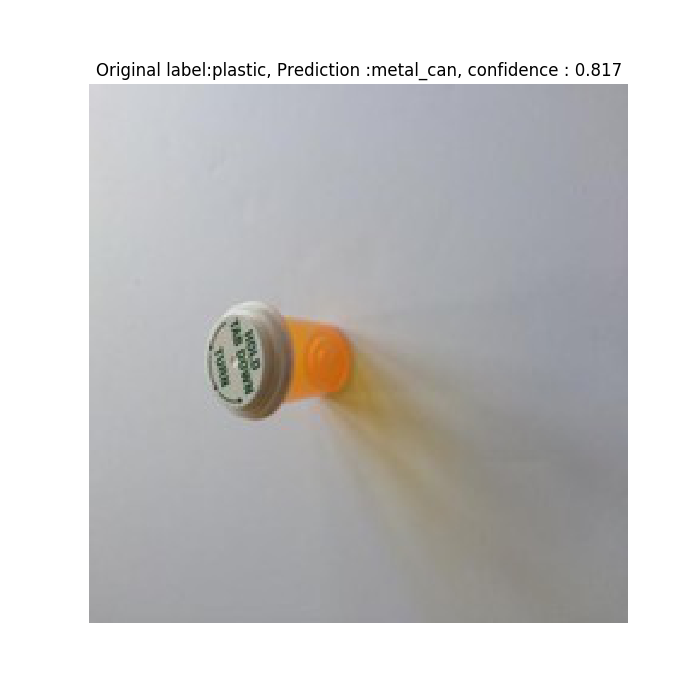
software/recognition/figures/best_case_0227/60.png
