adwikara/Ecobin/software/recognition/figures/best_case_0227/61.png

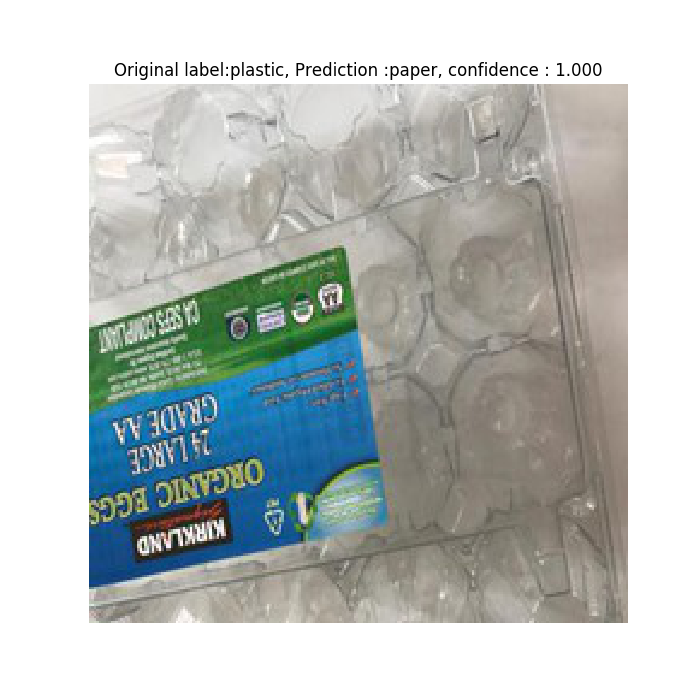
software/recognition/figures/best_case_0227/61.png
