adwikara/Ecobin/software/recognition/figures/best_case_0227/62.png

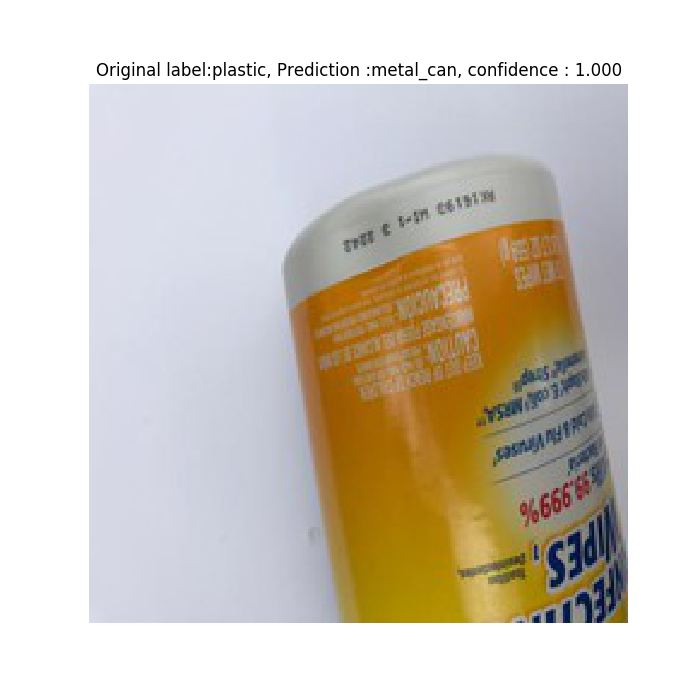
software/recognition/figures/best_case_0227/62.png
