adwikara/Ecobin/software/recognition/figures/best_case_0227/63.png

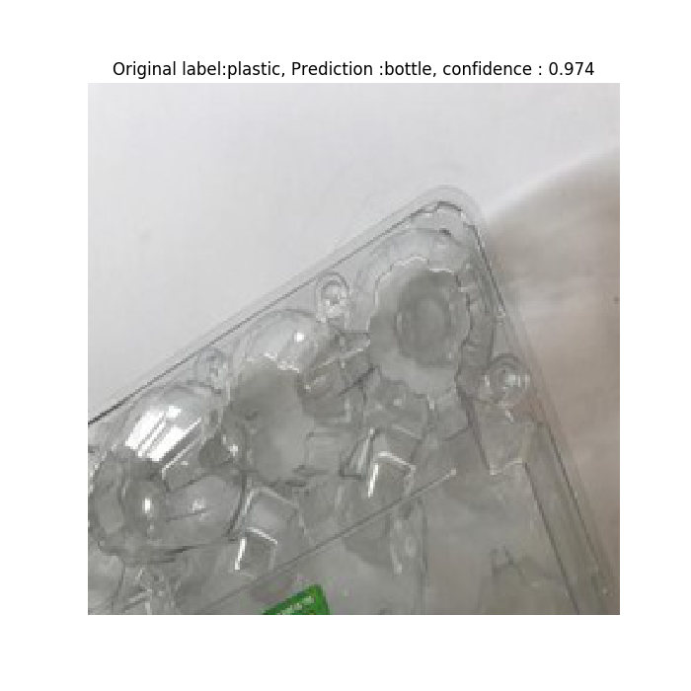
software/recognition/figures/best_case_0227/63.png
