adwikara/Ecobin/software/recognition/figures/best_case_0227/64.png

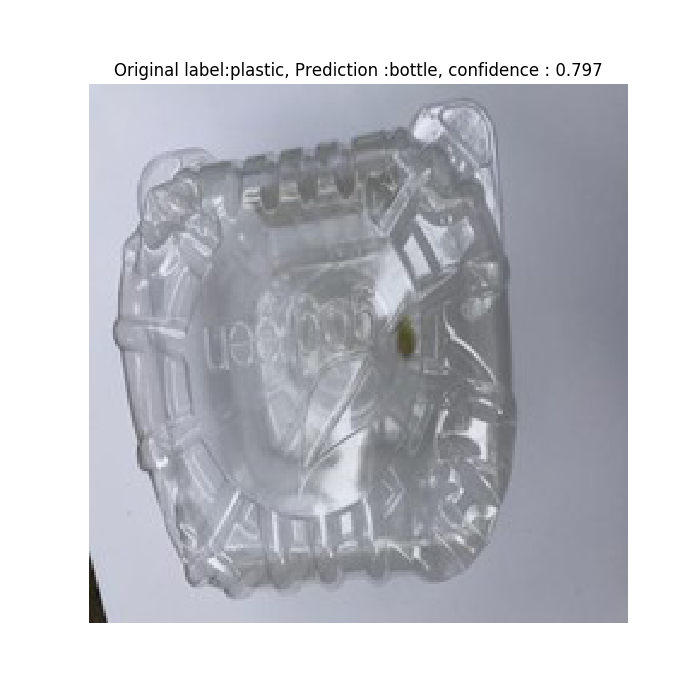
software/recognition/figures/best_case_0227/64.png
