adwikara/Ecobin/software/recognition/figures/best_case_0227/66.png

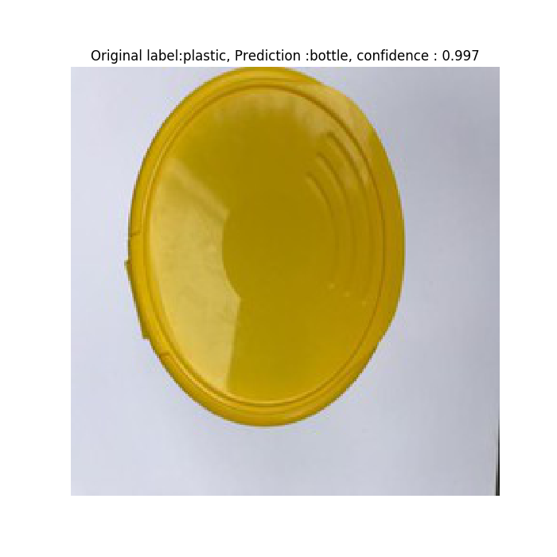
software/recognition/figures/best_case_0227/66.png
