adwikara/Ecobin/software/recognition/figures/best_case_0227/67.png

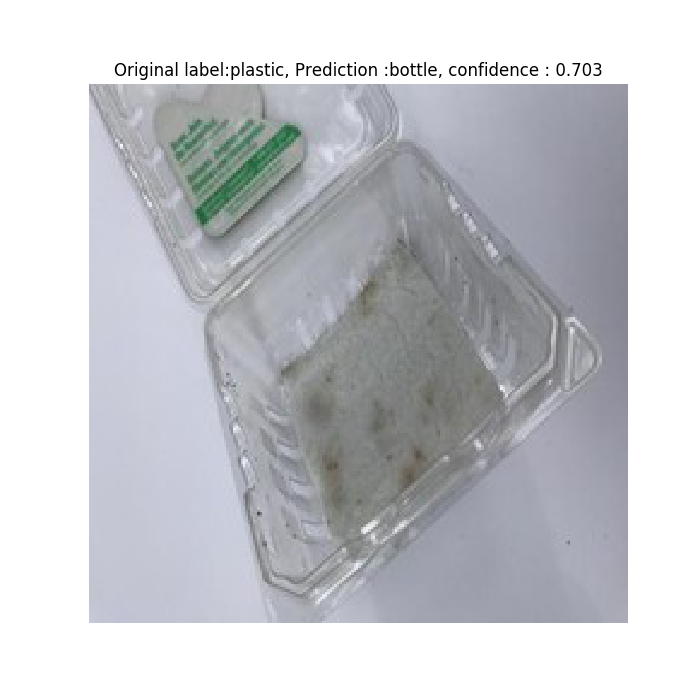
software/recognition/figures/best_case_0227/67.png
