adwikara/Ecobin/software/recognition/figures/best_case_0227/68.png

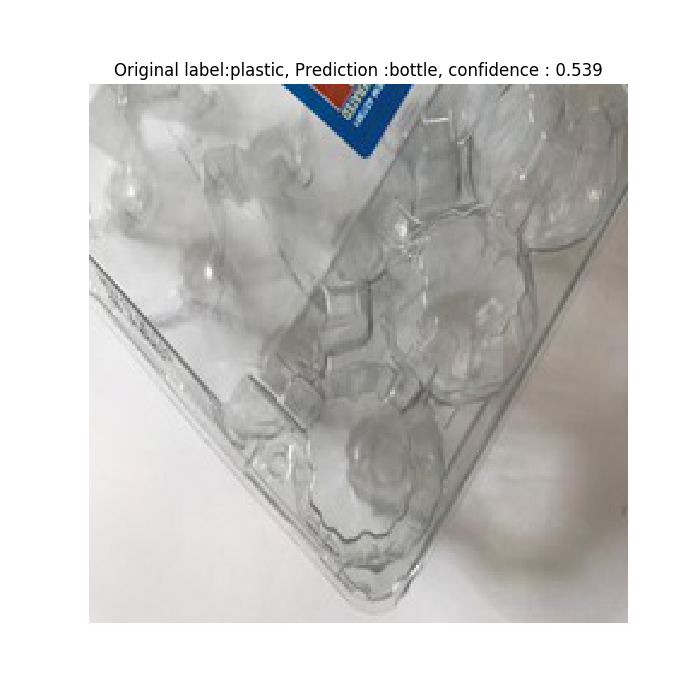
software/recognition/figures/best_case_0227/68.png
