adwikara/Ecobin/software/recognition/figures/best_case_0227/69.png

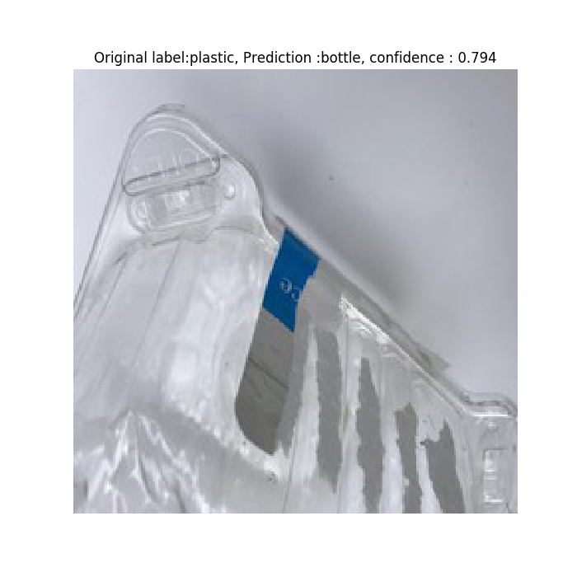
software/recognition/figures/best_case_0227/69.png
