adwikara/Ecobin/software/recognition/figures/best_case_0227/70.png

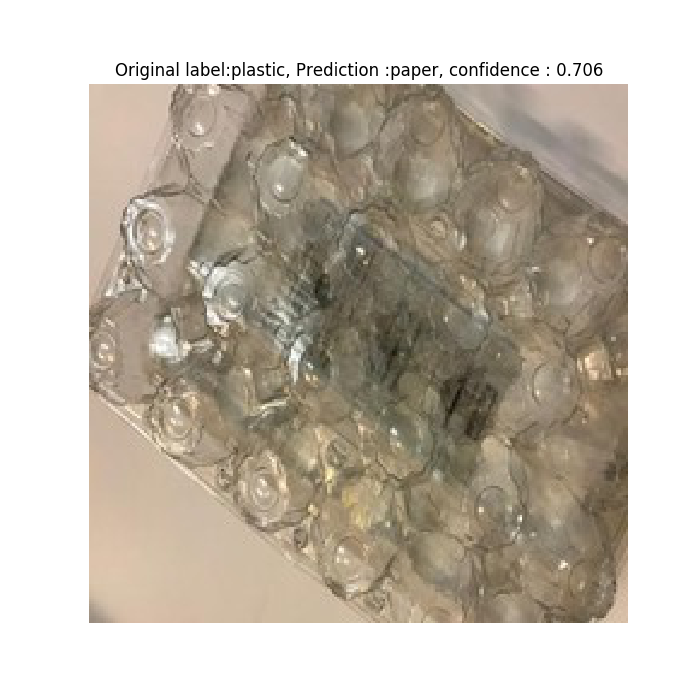
software/recognition/figures/best_case_0227/70.png
