adwikara/Ecobin/software/recognition/figures/best_case_0227/71.png

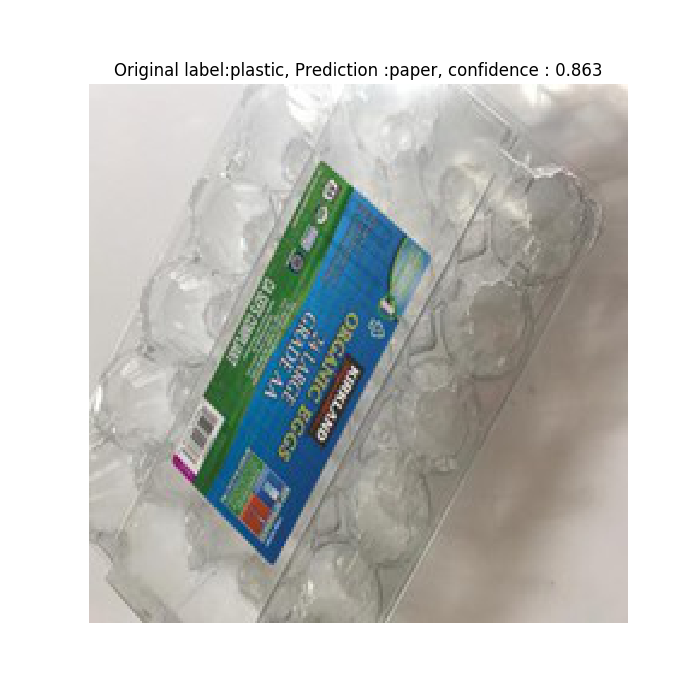
software/recognition/figures/best_case_0227/71.png
