adwikara/Ecobin/software/recognition/figures/best_case_0227/72.png

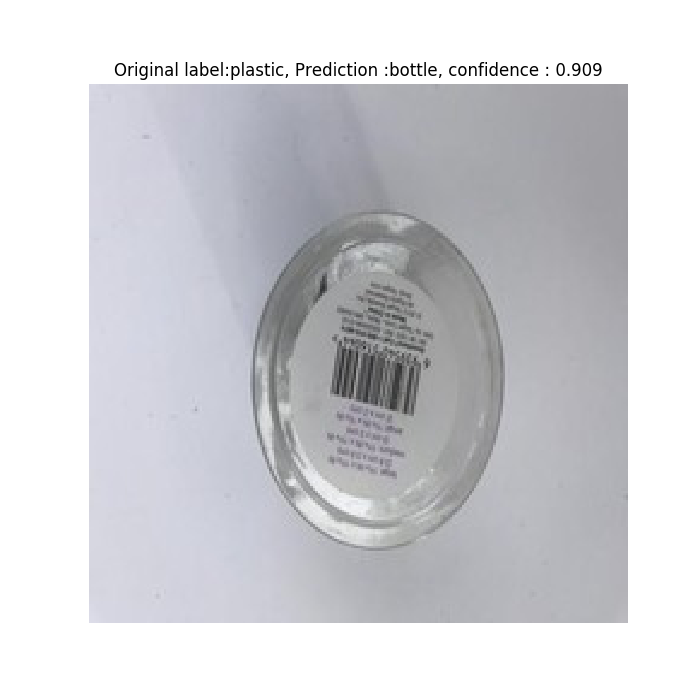
software/recognition/figures/best_case_0227/72.png
