adwikara/Ecobin/software/recognition/figures/best_case_0227/73.png

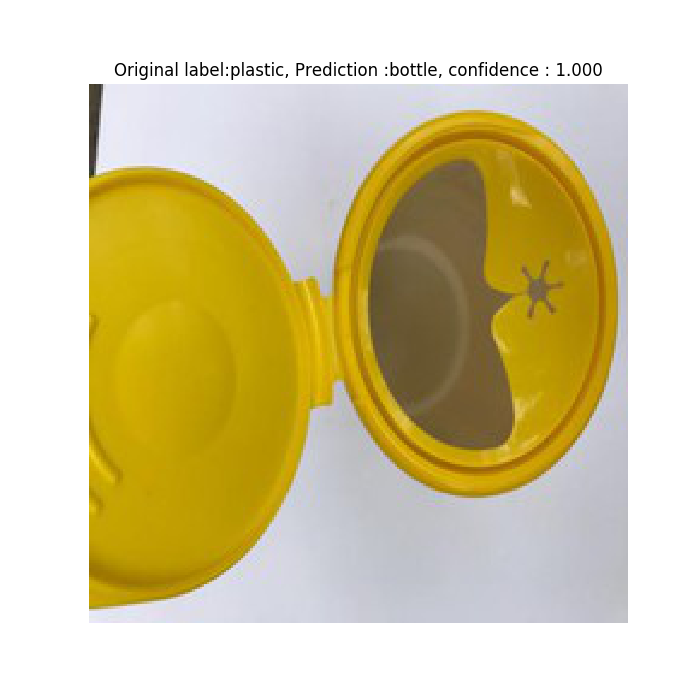
software/recognition/figures/best_case_0227/73.png
