adwikara/Ecobin/software/recognition/figures/best_case_0227/74.png

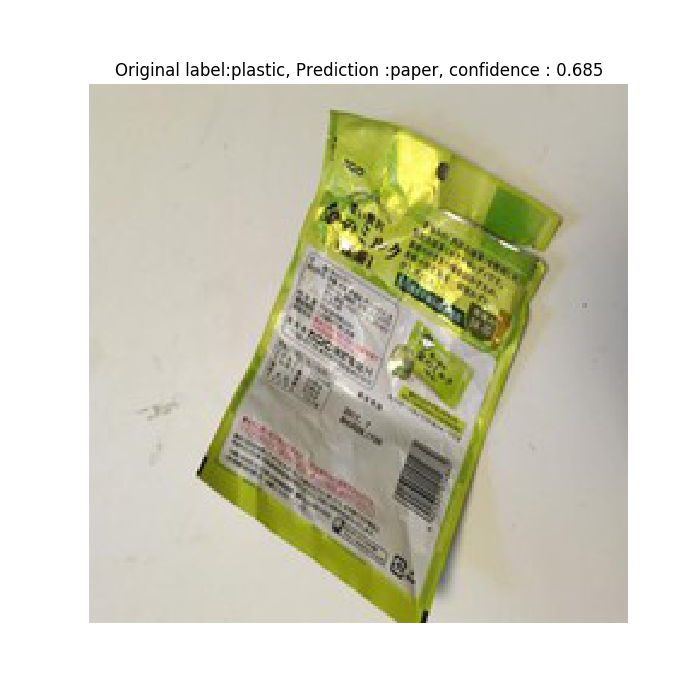
software/recognition/figures/best_case_0227/74.png
