adwikara/Ecobin/software/recognition/figures/best_case_0227/75.png

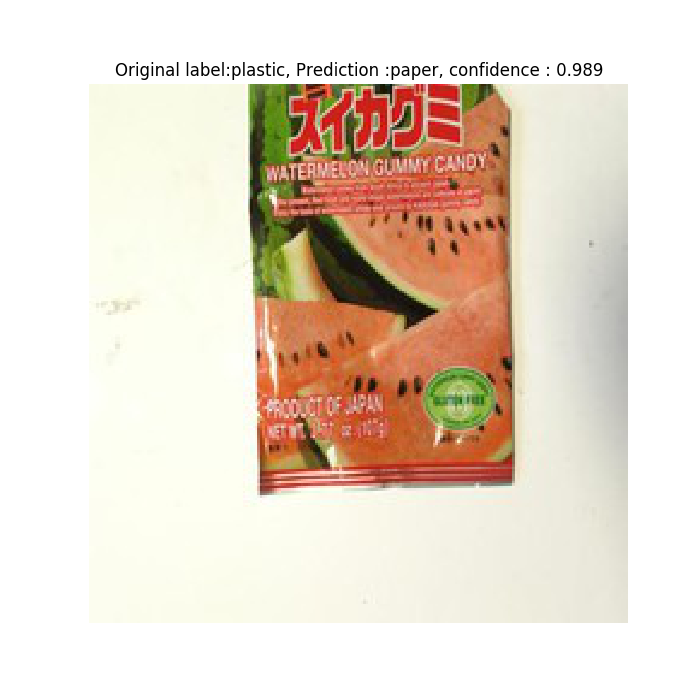
software/recognition/figures/best_case_0227/75.png
