adwikara/Ecobin/software/recognition/figures/best_case_0227/76.png

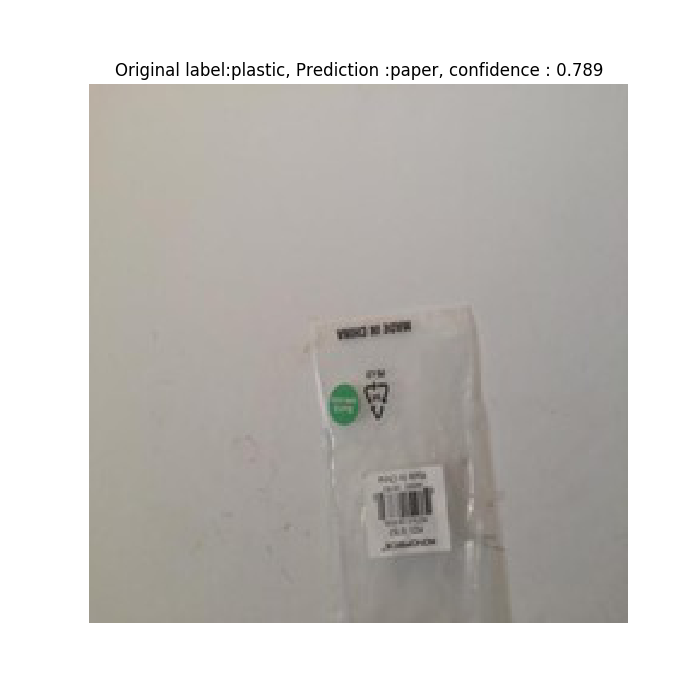
software/recognition/figures/best_case_0227/76.png
