adwikara/Ecobin/software/recognition/figures/best_case_0227/77.png

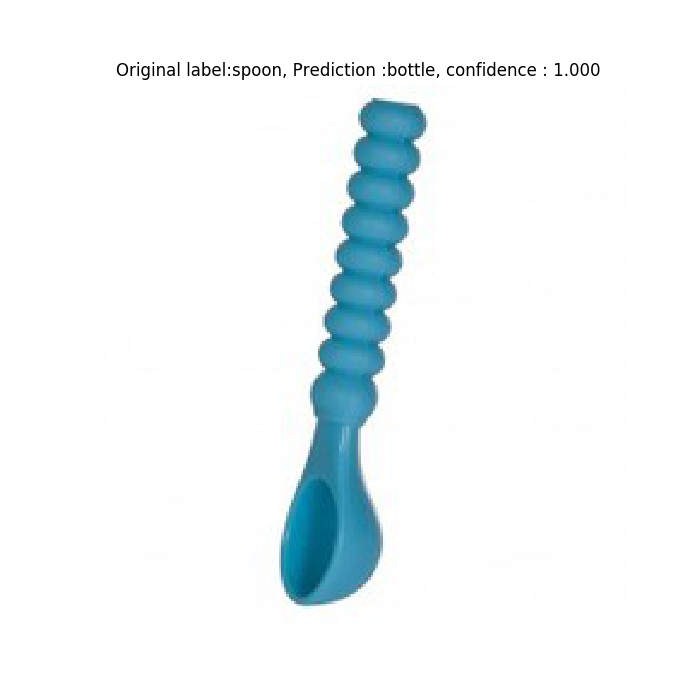
software/recognition/figures/best_case_0227/77.png
