adwikara/Ecobin/software/recognition/figures/best_case_0227/78.png

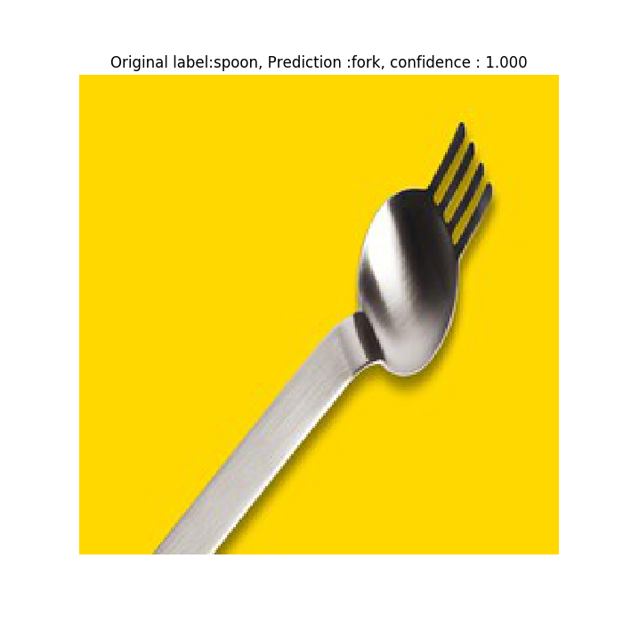
software/recognition/figures/best_case_0227/78.png
