adwikara/Ecobin/software/recognition/figures/best_case_0227/79.png

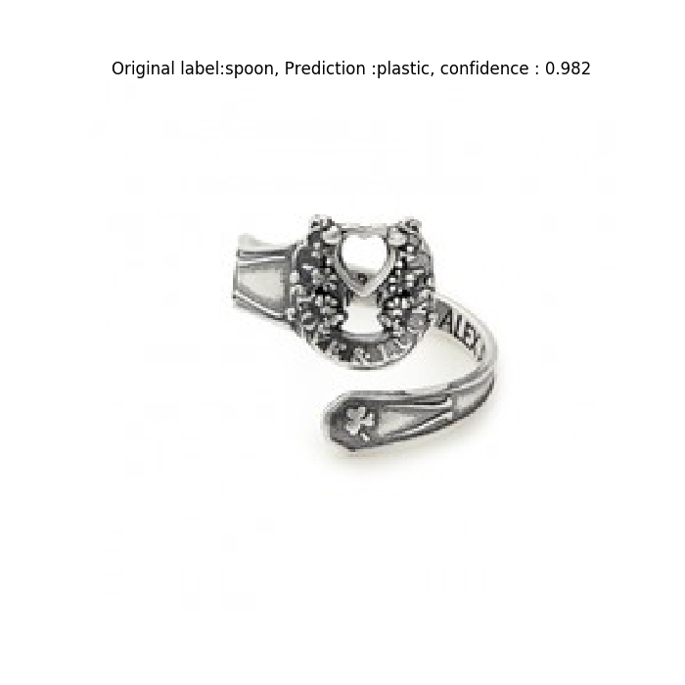
software/recognition/figures/best_case_0227/79.png
