adwikara/Ecobin/software/recognition/figures/best_case_0227/80.png

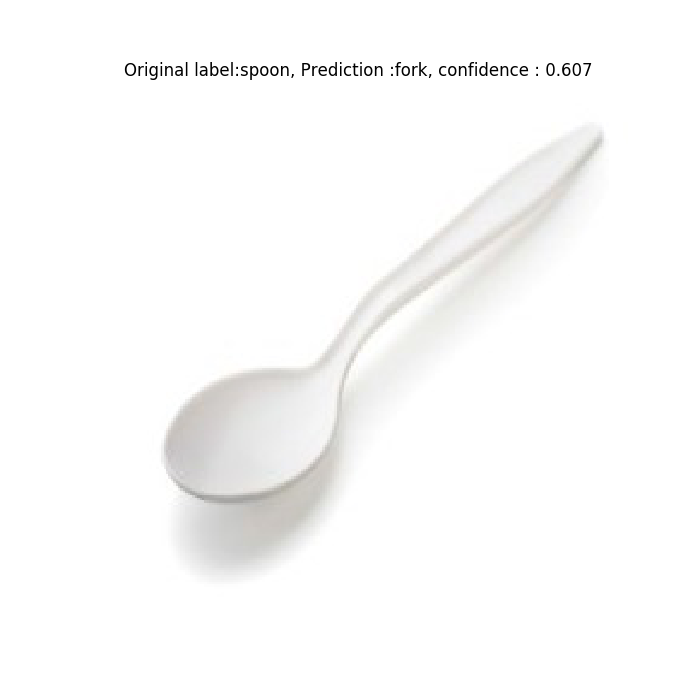
software/recognition/figures/best_case_0227/80.png
