adwikara/Ecobin/software/recognition/figures/best_case_0227/81.png

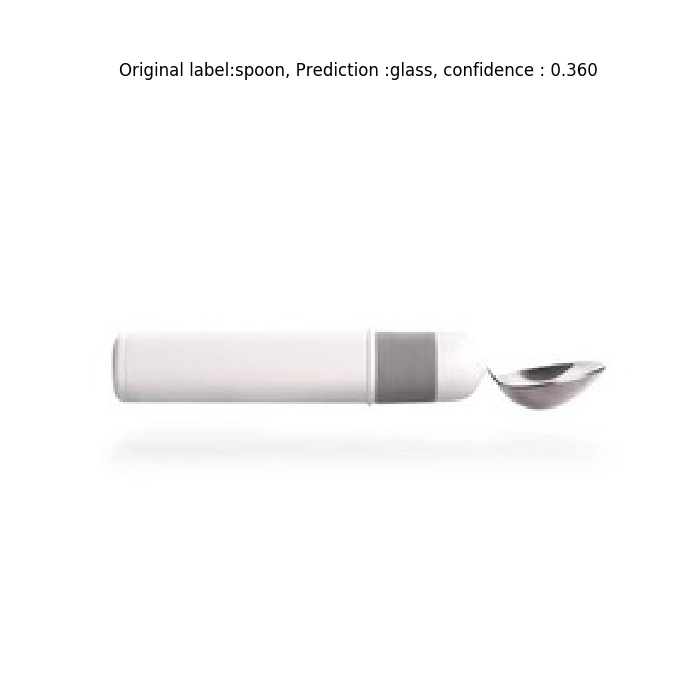
software/recognition/figures/best_case_0227/81.png
