adwikara/Ecobin/software/recognition/figures/best_case_0227/acc.png

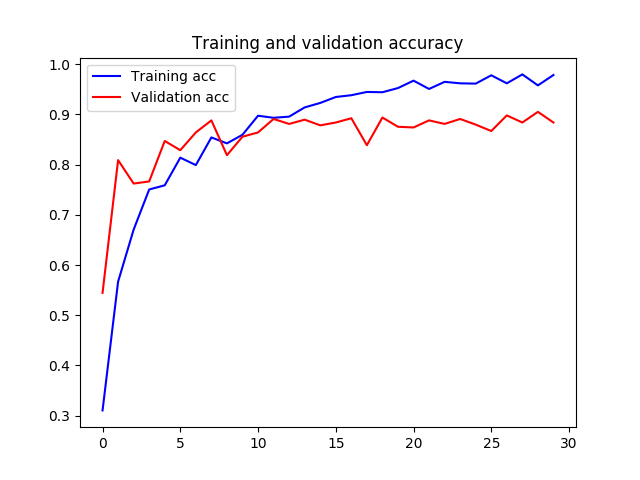
software/recognition/figures/best_case_0227/acc.png
