adwikara/Ecobin/software/recognition/figures/best_case_0227/loss.png

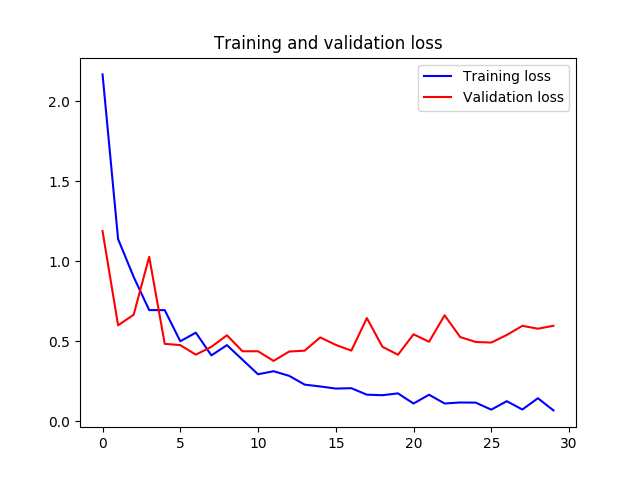
software/recognition/figures/best_case_0227/loss.png
